chevalierid/alan-setup/fab/kicad/controller_pcb/schematic.jpeg

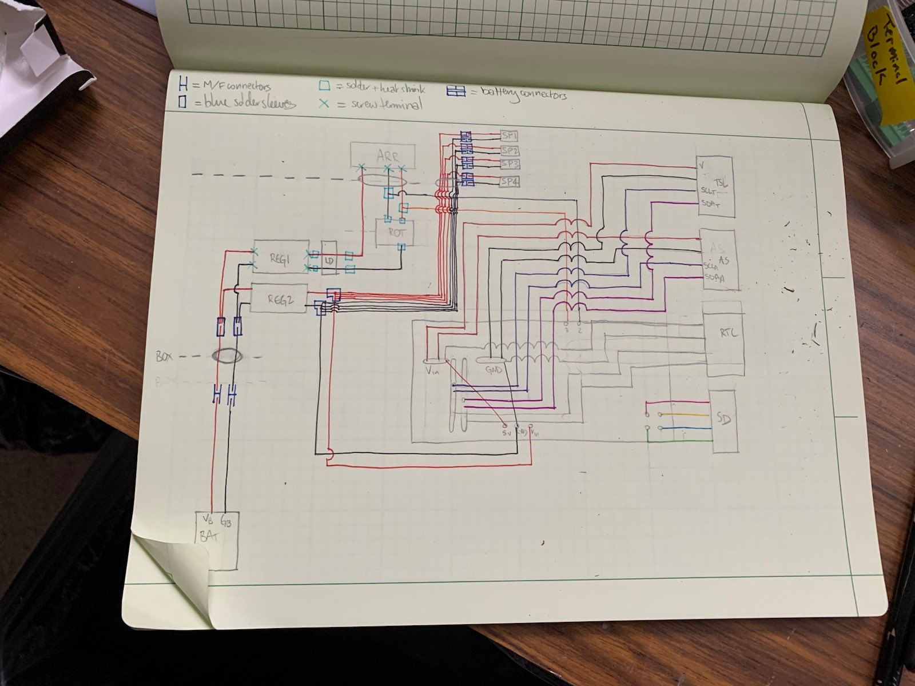
fab/kicad/controller_pcb/schematic.jpeg
