chevalierid/alan-setup/README.md

# alan-setup
Materials for experimental setup examining the effects of artificial light at night on insects
