chevalierid/alan-setup/prog/refactored/scripts/clean_sensor_data.Rmd

---
title: "clean_sensor_data"
output: html_document
date: "2024-04-24"
---

The purpose of this file is to clean the sensor data and interpolate it so that each site shares a common timescale.

```{r}
library(data.table)
library(lubridate)
library(remedy)
library(ggplot2)
```

## Read in our collated data
```{r}
sensor_data <- fread("../raw_data/raw_sensor_data_collated.csv")
metadata <- fread("../raw_data/raw_sensor_metadata_collated.csv")
```

## Remove bad/corrupted files where sensor_data LabelledSite is 0 and metadata Site is NA
```{r}
sensor_data <- sensor_data[sensor_data$LabelledSite %in% 1:12,]
```

## Sort by time
```{r}
setorder(sensor_data,cols="Timestamp")
```

### Make column for treatment (converting amber/white/on)

 A | W | O | Override | State
-------------------------
 0 | 1 | 1 | 0 | white, on
 0 | 1 | 0 | 0 | white, off
 0 | 1 | 1 | 1 | white, off, override
 1 | 1 | 1 | 0 | control, on
 1 | 1 | 0 | 0 | control, off
 1 | 1 | 1 | 1 | control, off, override
 1 | 0 | 1 | 0 | amber, on
 1 | 0 | 0 | 0 | amber, off
 1 | 0 | 1 | 1 | amber, off, override

A=0 W=1: white
A=1 W=0: amber
A=1 W=1: control

Compute treatment column as follows:
* control = A & W
* amber = A & !W
* white = !A & W

```{r}
sensor_data[, Treatment := fcase(
  sensor_data$Amber & sensor_data$White, "C",
  sensor_data$Amber & !sensor_data$White, "A",
  !sensor_data$Amber & sensor_data$White, "W"
)]
```

Any NA-treatment observations should be removed (checked).
```{r}
#sensor_data <- sensor_data[!is.na(Treatment)]
```

## Sites and states

For each labelled site and folder, we must retrieve actual site and state from metadata. 

This is harder than it first appears. We first must find the time interval corresponding to each data table entry. The metadata table contains each site's scheduled treatment for each 5-day interval and refers to each interval by its start date. In practice, the sites' states were changed on a regular schedule, but sometime during the day (slightly after the theoretical start date) rather than at midnight. We must make sure that all data corresponding to each interval is associated with that interval's start date. 

We first find points in time where treatment changed and create a new column for these timestamps (titled Changepoints).

```{r}
setorder(sensor_data,LabelledSite,Timestamp)

# here we get the row indices of every change point by site
# have to manually handle firsts, both by folder and site
sensor_data[Treatment != shift(Treatment, 1L, type="lag") | 
            Timestamp %in% sensor_data[!duplicated(sensor_data[,c("LabelledSite","Folder"),with=F])]$Timestamp, 
            Changepoint := Timestamp, by=.(LabelledSite,Folder)]
  
# have to manually handle when it's been too long since a changepoint (to capture times where there was a long gap in data collection), by folder and site

```

```{r eval = FALSE, echo = FALSE}
pdf("../plots/changepoints_before.pdf", w=16, h=9)
ggplot() +
  geom_point(data=sensor_data, aes(x=Timestamp,y=Treatment,colour=as.factor(Folder),alpha=0.5)) +
  geom_point(data=metadata, aes(x=as.POSIXct(StartDate,origin = "1970-01-01",tz="PST"),y=PrescribedTreatment,alpha=0.5)) +
  geom_point(data=sensor_data, aes(x=Changepoint,y=Treatment,colour="red")) +
  geom_vline(data = sensor_data[Intensity == -1,.SD,.SDcols = c("Timestamp","LabelledSite")], aes(xintercept = as.POSIXct(Timestamp)),alpha=0.3) +
  scale_x_datetime(
    breaks=seq(min(as.POSIXct(metadata$StartDate,origin="1970-01-01", tz="PST")),
               max(as.POSIXct(metadata$StartDate,origin="1970-01-01", tz="PST")), by="5 days"),
    date_labels = "%b %d", timezone="PST") +
  theme(axis.text.x=element_text(angle=60, hjust=1)) +
  facet_grid(rows = vars(LabelledSite))
dev.off()

pdf("../plots/changepoints2.pdf", w=16, h=9)
ggplot() +
  geom_point(data=sensor_data[LabelledSite == 11], aes(x=Timestamp,y=c("0", diff(as.numeric(Timestamp))),colour=as.factor(Folder),alpha=0.5)) +
  scale_x_datetime(
    breaks=seq(min(metadata$StartDate),max(metadata$StartDate), by="5 days"),
    date_labels = "%b %d", timezone="PST") +
  theme(axis.text.x=element_text(angle=60, hjust=1)) +
  #facet_grid(rows = vars(LabelledSite)) +
  geom_vline(data = metadata, aes(xintercept = StartDate),alpha=0.3)
dev.off()

find_data <- sensor_data[LabelledSite == 10
                         & Timestamp > as.POSIXct("2023-10-18", origin = "1970-01-01")
                         & Timestamp < as.POSIXct("2023-10-25", origin = "1970-01-01")]

find_data <- sensor_data[LabelledSite %in% c(10), Timestamp := Timestamp - hours(8)]
find_data <- find_data[LabelledSite %in% c(6), Timestamp := Timestamp - hours(7)]
find_data <- sensor_data[Timestamp > as.POSIXct("2023-10-28 09:52:11", origin = "1970-01-01", tz = "PST")
                         & Timestamp < as.POSIXct("2023-11-12 10:30:24", origin = "1970-01-01", tz = "PST")]

find_data <- sensor_data[LabelledSite == 12 & Timestamp > as.POSIXct("2023-10-28 09:52:11", origin = "1970-01-01", tz = "PST")
                                            & Timestamp < as.POSIXct("2023-11-12 10:30:24", origin = "1970-01-01", tz = "PST")]
pdf("../plots/changepoints-12.pdf", w=16, h=3)
ggplot() +
  geom_point(data=find_data, aes(x=Timestamp,y=Treatment,colour=as.factor(LabelledSite),alpha=0.5)) +
  #geom_point(data=find_data, aes(x=Changepoint,y=1,colour="red")) +
  scale_x_datetime(
    breaks=seq(min(find_data$Timestamp),max(find_data$Timestamp), by="12 hours"),
    date_labels = "%d %H", timezone="PST") +
  theme(axis.text.x=element_text(angle=60, hjust=1)) +
  facet_grid(rows = vars(Folder)) +
  geom_vline(data = find_metadata, aes(xintercept = StartDate),alpha=0.3)
dev.off()

find_data <- sensor_data[LabelledSite == 8 & Timestamp > as.POSIXct("2023-11-03 00:52:11", origin = "1970-01-01", tz = "PST")
                                            & Timestamp < as.POSIXct("2023-11-04 10:00:00", origin = "1970-01-01", tz = "PST")]
pdf("../plots/changepoints-8.pdf", w=16, h=16)
ggplot() +
  geom_point(data=find_data, aes(x=Timestamp,y=AS02,colour=as.factor(LabelledSite),alpha=0.5)) +
  geom_line(data=find_data, aes(x=Timestamp,y=Intensity,colour=as.factor(LabelledSite),alpha=0.5)) +
  #geom_point(data=find_data, aes(x=Changepoint,y=1,colour="red")) +
  scale_x_datetime(
    breaks=seq(min(as.POSIXct("2023-06-26 12:00:00", origin = "1970-01-01", tz = "PST")),
               max(as.POSIXct("2023-12-03 12:00:00", origin = "1970-01-01", tz = "PST")),
               by="24 hour"),
    date_labels = "%d %H", timezone="PST") +
  theme(axis.text.x=element_text(angle=60, hjust=1)) +
  facet_grid(rows = vars(LabelledSite)) +
  geom_vline(data = find_metadata, aes(xintercept = StartDate),alpha=0.3)
dev.off()

pdf("../plots/find_changepoints_8.pdf", w=16, h=1)
ggplot() +
  geom_point(data=find_data, aes(x=Timestamp,y=1,colour=as.factor(LabelledSite),alpha=0.5)) +
  scale_x_datetime(
    breaks=seq(min(as.POSIXct("2023-06-26 12:00:00", origin = "1970-01-01", tz = "PST")),
               max(as.POSIXct("2023-12-03 12:00:00", origin = "1970-01-01", tz = "PST")),
               by="2 hours"),
    date_labels = "%d %H", timezone="PST") +
  theme(axis.text.x=element_text(angle=60, hjust=1))
dev.off()

```

We add manual changepoints for exceptional cases. We also add a special treatment symbol because some had a wiggly cable and had a lot of NA treatment values.
```{r}
# match based on LabelledSite, Folder, and Timestamp
manual_changepoints <- fread("../raw_data/Collection Date Site Treatment and Notes(Manual).csv")
manual_changepoints[, `:=` (Timestamp = gsub("\xa0"," ",Timestamp), LastPoint = gsub("\xa0"," ",LastPoint))]
manual_changepoints[, `:=` (Timestamp = as.POSIXct(Timestamp, origin = "1970-01-01", tz="PST"),
                      LastPoint = as.POSIXct(LastPoint, origin = "1970-01-01", tz="PST"))]
manual_changepoints[, Treatment := gsub("$","*",Treatment)]
sensor_data[Changepoint %in% manual_changepoints$Timestamp]

# match row in sensor_data to row in manual_changepoints
sensor_data[manual_changepoints, `:=` (Changepoint = i.Timestamp, Treatment = i.Treatment), on = .(Folder,LabelledSite,Timestamp)]
sensor_data[Changepoint %in% manual_changepoints$Timestamp]
length(grep("*", sensor_data$Treatment, fixed=TRUE))
```

For each changepoint, we find the most recent start date in a new column, StartDate. 
```{r}
# set each value of StartDate to the closest entry in unique(metadata$StartDate)
maxless <- function(input, labels) {
  return(as.POSIXct(max(as.numeric(as.POSIXct(labels,origin="1970-01-01",tz="PST"))
                        [as.numeric(as.POSIXct(labels,origin="1970-01-01",tz="PST")) <= as.numeric(input)]),origin="1970-01-01",tz="PST"))
}
# test_data <- copy(sensor_data[1:50000])
# test_data[, StartDate := maxless(Changepoint, unique(metadata$StartDate)), by=1:nrow(test_data)]
# # input = sensor_data$Changepoint
# # labels = unique(metadata$StartDate)

#unique(metadata$StartDate)[1] < unique(metadata$StartDate)[2]
#as.POSIXct(max(as.numeric(labels)[as.numeric(labels) <= as.numeric(input)]),origin="1970-01-01")

sensor_data[, StartDate := maxless(Changepoint, unique(metadata$StartDate)), by=1:nrow(sensor_data)]
#sensor_data[, Changepoint := ifelse(as.numeric(Changepoint) - as.numeric(Timestamp))]
```

Then we fill that column downward.
```{r}
sensor_data[, StartDate := nafill(StartDate, type="locf")]
sensor_data[, StartDate := as.Date(StartDate)]
```

Then we add a Site column based on LabelledSite, Folder, and StartDate.
```{r}
sensor_data[metadata, Site := i.Site, on = .(LabelledSite,Folder,StartDate)]
```

We also need to correct the treatment column for some manual-changepoint entries.
```{r}
## select combination of folder + labelledsite + startdate where sensor_data[grep("*",Treatment)]
test_data_5 <- copy(sensor_data[Site == 5])
test_data_8 <- copy(sensor_data[Site == 8])

test_data_1 <- data.table(Site = c(5,   5,   5,   5,    5,   7,   8,    8,   8,   8,  8),        # Create first data.table
                   Treatment = c("A*", "A", "A", "W*", "W", "C", "C*", "W", "W", "W", "W"),
                   Timestamp = 1:11,
                   StartDate = c(1, 1, 1, 2, 2, 1, 1, 1, 1, 1, 1))
which(test_data_1$Treatment %like% "\\*")
test_data_1[test_data_1[which(Treatment %like% "\\*")], on=.(Site, StartDate)]
test_data_1[test_data_1[which(Treatment %like% "\\*")], NewTreatment := i.Treatment, on=.(Site, StartDate)]

length(which(test_data_5$NewTreatment %like% "\\*"))
unique(test_data_5$NewTreatment)
unique(test_data_5$Treatment)
View(test_data_5[is.na(NewTreatment)])

test_data_1[test_data_1[which(Treatment %like% "\\*")], Treatment := ifelse(!Treatment %like% "\\*", NA, Treatment), on=.(Site, StartDate)]
            
test_data_5[test_data_5[which(Treatment %like% "\\*")], Treatment := ifelse(!Treatment %like% "\\*", NA, Treatment), on=.(Site, StartDate)]

!(Treatment %like% "\\*")

[, Treatment := NA]

dt[dt[, .I[sample(.N, 1)], a]$V1, s := TRUE]

View(sensor_data[LabelledSite == 5 & Timestamp > as.POSIXct("2023-07-01 00:52:11", origin = "1970-01-01", tz = "PST")
                                   & Timestamp < as.POSIXct("2023-07-03 10:00:00", origin = "1970-01-01", tz = "PST")])
#View(2023-07-02 01:00:06)

test_data_5[test_data_5[which(Treatment %like% "\\*")], NewTreatment := i.Treatment, on=.(Site, StartDate)]

View(test_data_5[test_data_5[,.SD[which(Treatment %in% c("A*","W*","C*"))]],
            on=.(Site,StartDate)])

test_data_5[, Treatment := replace(Treatment, )]

dt[, score:= replace(score, id == 'B' & is.na(score), score[which(id == 'A')[i1]])]

View(test_data_8[test_data_8[,.SD[which(Treatment %in% c("A*","W*","C*"))]], NewTreatment := i.Treatment,
            on=.(Folder,LabelledSite,Site,StartDate)])

test_data_5[test_data_5[,.SD[which(Treatment %in% c("A*","W*","C*"))]],
            on=.(Folder,Site,LabelledSite,StartDate),
            NewTreatment := Treatment[nafill(replace(.I, is.na(Treatment), NA),"locf")]]

length(grep("*", test_data_5$Treatment, fixed=TRUE))

View(test_data_5)

View(sensor_data[LabelledSite == 8 & Timestamp > as.POSIXct("2023-11-03 00:52:11", origin = "1970-01-01", tz = "PST")
                              & Timestamp < as.POSIXct("2023-11-04 10:00:00", origin = "1970-01-01", tz = "PST")])
View(sensor_data[LabelledSite == 8 & Timestamp > as.POSIXct("2023-11-13 00:52:11", origin = "1970-01-01", tz = "PST")
                              & Timestamp < as.POSIXct("2023-11-14 10:00:00", origin = "1970-01-01", tz = "PST")])

sensor_data[sensor_data[,.SD[which(Treatment %in% c("A*","W*","C*"))]],
            on=.(Folder,LabelledSite,StartDate),
            Treatment := gsub("*","",Treatment,fixed=TRUE)]

length(grep("*", sensor_data$Treatment, fixed=TRUE))

sensor_data[LabelledSite == 5
                         & Timestamp > as.POSIXct("2023-06-26", origin = "1970-01-01")
                         & Timestamp < as.POSIXct("2023-07-26", origin = "1970-01-01")]
```

```{r}
pdf("../plots/changepoints_after.pdf", w=16, h=9)
ggplot() +
  geom_point(data=sensor_data, aes(x=Timestamp,y=Treatment,colour=as.factor(Folder),alpha=0.5)) +
  geom_point(data=metadata, aes(x=as.POSIXct(StartDate,origin="1970-01-01",tz="PST"),y=PrescribedTreatment,alpha=0.5)) +
  geom_point(data=sensor_data, aes(x=Changepoint,y=Treatment,colour="red")) +
  scale_x_datetime(
    breaks=seq(min(as.POSIXct(metadata$StartDate,origin="1970-01-01", tz="PST")),max(as.POSIXct(metadata$StartDate,origin="1970-01-01", tz="PST")), by="5 days"),
    date_labels = "%b %d", timezone="PST") +
  theme(axis.text.x=element_text(angle=60, hjust=1)) +
  facet_grid(rows = vars(Site)) +
  geom_vline(data = metadata, aes(xintercept = as.POSIXct(StartDate,origin="1970-01-01",tz="PST")),alpha=0.3)
dev.off()
```

Now we have a column stating the interval (identified by its first sampling day) for each observation. Let's properly assign site labels.
```{r}
#fread("../raw_data/Collection Date Site Treatment and Notes(LongFormat).csv")
source("reshape.R")
str(status_table)
str(metadata)
summary(status_table)

# metadata$Timestamp    & sensor_data$StartDate
# metadata$Folder       & sensor_data$Folder
# metadata$LabelledSite & sensor_data$LabelledSite
# metadata$Site         & sensor_data$Site (:=)

#metadata [, StartDate := as.Date(Timestamp),]
# Timestamp is now redundant and we only want it to refer to the timestamp of a specific observation
# PrescribedTreatment refers to the prescribed treatment, which wasn't always the treatment condition present. We will pull treatment from our observations later on

#metadata[, c("Timestamp","PrescribedTreatment") := NULL,]
sensor_data[, StartDate := as.Date(StartDate, format="%Y-%m-%d", origin = "1970-01-01",tz="PST"),]
metadata[, StartDate := as.Date(StartDate, format="%Y-%m-%d", origin = "1970-01-01",tz="PST"),]
#    long           short           long
#joined_table <- na.omit(metadata)[sensor_data, on=.(StartDate, Folder, LabelledSite)]

joined_table

joined_table <- metadata[sensor_data, on=.(StartDate, Folder, LabelledSite)][!is.na(Site)]

#joined_table[, Changepoint := NULL,]

unique(joined_table[Site == 7]$StartDate)

##################
# why don't we have data for site 7 startdate 2023-11-28...we should have it
####################

#sensor_data[Site == 7 & StartDate == as.Date("2023-11-28")]

# add actual treatment to metadata table
# some site-startdate combos have a few data points under a different treatment
# choose most common treatment for each site-startdate combo

metadata <- joined_table[Site %in% 1:12, .N, by=.(Site, StartDate, Treatment)][, .SD[which.max(N)], by = .(Site, StartDate)][metadata, on = .(Site, StartDate)]
metadata[, N := NULL,]

all.equal(metadata$Treatment[1], metadata$Folder[1])

pdf("../plots/treatments.pdf", w=16, h=9)
ggplot() +
  geom_point(data=na.omit(metadata), aes(x=as.Date(StartDate),y=Treatment,colour=as.factor(Treatment))) +
  facet_grid(rows = vars(Site))
dev.off()
```

### Get min and max timestamp
```{r}
x_min <- min(sensor_data$Timestamp)
x_max <- max(sensor_data$Timestamp)
```

## Plot before interpolation
```{r}
pdf("../plots/changepoints_final.pdf", w=16, h=9)
ggplot() +
  geom_point(data=joined_table, aes(x=Timestamp,y=Treatment,colour=as.factor(Folder),alpha=0.5)) +
  geom_point(data=metadata, aes(x=as.POSIXct(StartDate),y=PrescribedTreatment,alpha=0.5)) +
  #geom_point(data=joined_table, aes(x=Changepoint,y=Treatment,colour="red")) +
  scale_x_datetime(
    breaks=seq(min(as.POSIXct(metadata$StartDate,origin="1970-01-01", tz="PST")),
               max(as.POSIXct(metadata$StartDate,origin="1970-01-01", tz="PST")), by="5 days"),
    date_labels = "%b %d", timezone="PST") +
  theme(axis.text.x=element_text(angle=60, hjust=1)) +
  facet_grid(rows = vars(Site)) +
  geom_vline(data = metadata, aes(xintercept = as.POSIXct(StartDate)),alpha=0.3)
dev.off()
```

### Create new x
We will use linear interpolation (approxfun) from floor(min_timestamp/300) * 300 to ceiling(max_timestamp/300) * 300, using seq(from, to, by=300). Here we prepare our time-series x-variable.
```{r}
x_inter <- seq(floor(as.numeric(x_min)/300)*300,
    ceiling(as.numeric(x_max)/300)*300,
    by=300)
```

### Interpolate
```{r}
data_cols <- c(paste("AS", c(1:9), sep="0"), "AS10", "AS11", "Intensity")

interp_table <- joined_table[Site %in% 1:12, lapply(.SD, function(col) approx(x = Timestamp, y = col, xout = x_inter)$y), by=Site, .SDcols = data_cols]
interp_table[, Timestamp := as.POSIXct(x_inter,origin="1970-01-01"), by=Site]
interp_table[, Treatment := joined_table[interp_table, x.Treatment, on=.(Site, Timestamp), roll = "nearest"]]
interp_table[, StartDate := joined_table[interp_table, x.StartDate, on=.(Site, Timestamp), roll = "nearest"]]
interp_table[, LightOn := joined_table[interp_table, x.On, on=.(Site, Timestamp), roll = "nearest"]]
interp_table

pdf("../plots/interp.pdf", w=16, h=9)
ggplot(data=interp_table[Site == 6 & LightOn == 1 & Timestamp %between% c(as.POSIXct("2023-07-05"), as.POSIXct("2023-08-01"))]) +
  geom_point(aes(x=Timestamp,y=Intensity)) +
  #geom_point(aes(x=Timestamp,y=AS03),colour="blue") +
  #geom_point(aes(x=Timestamp,y=AS05),colour="green") +
  #geom_point(aes(x=Timestamp,y=AS06),colour="orange")+
  theme(text = element_text(size=rel(3.5))) +
  labs(y = "Intensity")
dev.off()

fwrite(metadata, file="../cleaned_data/metadata.csv")
fwrite(interp_table, file = "../cleaned_data/interpolated_data.csv")
```
