chevalierid/alan-setup/prog/processing.Rmd

```{r}
library(data.table)
library(ggplot2)
library(lubridate)
library(remedy)
```
## Set working directory
```{r setup}
knitr::opts_knit$set(root.dir="~/Documents/alan-setup")
```

### Import labels table (prescribed states)
```{r}
source("./prog/site_assign_label_gen.R")
labels_table <- melt(setDT(labels), measure = patterns(c("^dates_out","^sites","^site_settings")),
     value.name = c("Timestamp", "LabelledSite", "LTreatment"))
labels_table <- labels_table[,.SD,
             .SDcols = c("Timestamp", "LabelledSite", "LTreatment")]
labels_table$Timestamp <- with_tz(as.POSIXct(labels_table$Timestamp), "PST")
setorder(labels_table,Timestamp)
```

### Import status table (whether sites were collecting data over a given interval)
```{r}
source("./prog/reshape.R")
str(status_table)
str(labels_table)
summary(status_table)
#max(labels_table[Timestamp <= max(status_table$Date)]$Timestamp)
# equality comparison works between labels_table$Timestamp and status_table$Date :-)

# trim labels_table
labels_table <- labels_table[Timestamp <= max(status_table$Timestamp)]
#labels_table <- labels_table[Timestamp %in% status_table$Timestamp]

#labels_table <- labels_table[status_table, on = c("Timestamp" , "LabelledSite")]

# add a column to labels_table that indicates the actual status of given site at given interval
# retrieve status_table$Status by matching labels_table$Timestamp to status_table$Timestamp and labels_table$Site to status_table$Site

# view(labels_table[status_table, on = c("Timestamp","LabelledSite"), fcase(
#   !(i.Status %in% c("", "dep")) | is.na(i.Folder) | is.na(i.Site), 0,
#   default = 1
#   )])

labels_table[status_table, on = c("Timestamp","LabelledSite"), c("Status","Folder","Site") := list(fcase(
  !(i.Status %in% c("", "dep")) | is.na(i.Folder) | is.na(i.Site), 0,
  default = 1
  ), i.Folder, i.Site)]

head(labels_table)
```

### Downloading sensor data
* s3cmd la
* s3cmd get --recursive s3://alan-stations-sensordata/
* stored in alan-setup/sensordata

### Set up timeframe bounds
We want to bound the time frame within study period (hardcoded in here) to only download files that are from the correct timespan. Recall the format string is month.day.hour.
```{r}
start_date <- as.POSIXct("23.06.21.00",format="%y.%m.%d.%H")
end_date <- as.POSIXct("23.12.04.23",format="%y.%m.%d.%H")
all_dates <- seq.POSIXt(start_date, end_date, "hour")

all_dates <- format(all_dates,"%m-%d-%H")
```

### Format file names as dates
We need to remove the ".CSV" termination and convert the remaining string to a POSIXct (date-time) format. Malfunctioning clocks resulted in some data saved under impossible dates, e.g. 85-9-18, so we want to remove those as well.
```{r}
reform <- function (site_files_arg) {
  site_files_arg <- gsub(".CSV|\"","",site_files_arg)
  site_files_arg <- gsub("^","23-",site_files_arg)
  site_files_arg <- as.POSIXct(site_files_arg,format="%y-%m-%d-%H")
  format(site_files_arg,"%m-%d-%H")
}
```

### Get all site paths
```{r}
sites <- list.files(path="./sensordata", full.names = TRUE)
header <- c("Timestamp", "LabelledSite", "Amber", "White", "On", "Override", "Intensity",
               "AS00", "AS01", "AS02", "AS03", "AS04", "AS05", "AS06", "AS07", "AS08",
               "AS09", "AS10", "AS11")
```
 
### Reading in files
For a given site path, we want to read in and rbind together all non-blank files whose names fall within our timeframe. Some files have headers while others don't, so we always set the file header manually.
```{r}
get_files <- function(site) {
  files_within_bounds <- list.files(site)[reform(list.files(site)) %in% all_dates]
  # exclude blank files
  files_within_bounds <- files_within_bounds[file.size(paste(site,"/",files_within_bounds,sep=""))>0]
  site_table <- do.call(rbind,lapply(files_within_bounds,function(file) {
    data <- read.csv(paste(site,"/",file,sep=""))
    names(data) <- header
    return(data)
    # 2
  }))
}
```

### Read in data from all sites
```{r}
raw_output <- lapply(sites,get_files)
```

List of dataframes
```{r}
big_table <- raw_output
```

Now we have a list of dataframes. Some have char columns only, other have int and num. We'll have to convert them all before combining into a master table.

### Convert timestamp column to POSIXct
This has the added bonus of removing rogue "header rows" since their timestamp (which just reads "Timestamp") is converted to NA and excluded from the subset.
```{r}
big_table <- lapply(big_table, function(df) {
  df$Timestamp <- with_tz(as.POSIXct(as.numeric(df$Timestamp), origin = "1970-01-01"), "PST")
  df <- subset(df, Timestamp > start_date & Timestamp < end_date)
})
```

### Convert all the other columns to the correct type
```{r}
big_table <- lapply(big_table, function(df) {
  df[,-1] <- lapply(df[,-1], type.convert, as.is = TRUE)
  return(df)
    })
```

### Merge into a single data.table
Take unique values since some files were duplicated
```{r}
big_table <- unique(rbindlist(big_table,idcol="Folder"))
```

### Count how many of each timestamp for each LabelledSite and Folder
```{r}
big_table[,.N,by=.(as.Date(Timestamp),LabelledSite,Folder)][N>288]
```

### Remove bad/corrupted files where LabelledSite is 0
### Sort by time
```{r}
big_table <- big_table[big_table$LabelledSite %in% 1:12,]
str(labels_table)
# fix labels_table, up above
# match:
  # labels_table$Timestamp to big_table$Timestamp
  # labels_table$

#labels_table[Timestamp==big_table$Timestamp,]

# labels_table[status_table, on = c("Timestamp","LabelledSite"), c("Status", "Folder", "Site") := list(fcase(
#   i.Status %in% c("", "dep") | is.na(i.Folder) | is.na(i.Site), 1,
#   default = 0 # FIXME add a case for NA folder and site
#   ), i.Folder, i.Site)]

setorder(big_table,cols = "Timestamp")
```

### Make column for treatment (converting amber/white/on)

 A | W | O | Override | State
-------------------------
 0 | 1 | 1 | 0 | white, on
 0 | 1 | 0 | 0 | white, off
 0 | 1 | 1 | 1 | white, off, override
 1 | 1 | 1 | 0 | control, on
 1 | 1 | 0 | 0 | control, off
 1 | 1 | 1 | 1 | control, off, override
 1 | 0 | 1 | 0 | amber, on
 1 | 0 | 0 | 0 | amber, off
 1 | 0 | 1 | 1 | amber, off, override

A=0 W=1: white
A=1 W=0: amber
A=1 W=1: control

Compute treatment column as follows:
* control = A & W
* amber = A & !W
* white = !A & W

```{r}
big_table[, Treatment := fcase(
  big_table$Amber & big_table$White, "C",
  big_table$Amber & !big_table$White, "A",
  !big_table$Amber & big_table$White, "W"
  #,!big_table$Amber & !big_table$White, "U"
)]
```

Any NA-treatment observations should be removed (checked).
```{r}
big_table[is.na(Treatment), .N]
dim(big_table[is.na(Treatment)])
dim(big_table[!is.na(Treatment)])
big_table <- big_table[!is.na(Treatment)]
```

### For each labelled site and folder, retrieve actual site and state from labels_table
This is harder than it first appears. We first must find the time interval corresponding to each data table entry. The labels table contains each site's scheduled treatment for each 5-day interval and refers to each interval by its start date. In practice, the sites' states were changed on a regular schedule, but sometime during the day (slightly after the theoretical start date) rather than at midnight. We must make sure that all data corresponding to each interval is associated with that interval's start date. We first find points in time where treatment changed and create a new column for these timestamps (titled Changepoints).

```{r}
## get the timestamps at which treatment changes
# must group by LabelledSite and order by timestamps
# then find changepoints

setorder(big_table,LabelledSite,Timestamp)

# here we get the row indices of every change point by site
# have to manually handle firsts, both by folder and site

big_table[Treatment != shift(Treatment, 1L, type="lag") | Timestamp %in% big_table[!duplicated(big_table[,c("LabelledSite","Folder"),with=F])]$Timestamp, Changepoint := Timestamp, by=.(LabelledSite,Folder)]

```

For each changepoint, we find the most recent start date in a new column, StartDate. Then we fill that column downward with NAs.
```{r}
# set each value of StartDate to the closest entry in unique(labels_table$Timestamp)
maxless <- function(input, labels) {
  return(as.POSIXct(max(as.numeric(labels)[as.numeric(labels) <= as.numeric(input)]),origin="1970-01-01"))
}

#view(big_table[, maxless(Changepoint, labels_table$Timestamp), by=1:nrow(big_table)])
big_table[, StartDate := maxless(Changepoint, unique(labels_table$Timestamp)), by=1:nrow(big_table)]

big_table[, StartDate := nafill(StartDate, type="locf")]
```

Now we have a column stating the interval (identified by its first sampling day) for each observation. Let's properly assign site labels.
```{r}
# labels_table$Timestamp    & big_table$StartDate
# labels_table$Folder       & big_table$Folder
# labels_table$LabelledSite & big_table$LabelledSite
# labels_table$Site         & big_table$Site (:=)

# labels_table[status_table, on = c("Timestamp","LabelledSite"), 
#              c("Status", "Folder", "Site") := list(fcase(
#   i.Status %in% c("", "dep") | is.na(i.Folder) | is.na(i.Site), 1,
#   default = 0
# ), i.Folder, i.Site)]

# dt_a[dt_b, on = .(b = y, c > z)]

# labels_table[status_table, on = c("Timestamp","LabelledSite"), c("Status","Folder","Site") := list(fcase(
#   !(i.Status %in% c("", "dep")) | is.na(i.Folder) | is.na(i.Site), 0,
#   default = 1
#   ), i.Folder, i.Site)]

# view(big_table[labels_table, on=.(StartDate = Timestamp, Folder = Folder, LabelledSite = LabelledSite),
#           i.Site])
labels_table [, StartDate := as.Date(Timestamp),]
labels_table[, c("Timestamp","LTreatment") := NULL,]
big_table[, StartDate := as.Date(StartDate),]

#joined_table <- na.omit(labels_table[, !c("Timestamp","LTreatment", with = FALSE)])[big_table, on=.(StartDate, Folder, LabelledSite)]
joined_table <- na.omit(labels_table)[big_table, on=.(StartDate, Folder, LabelledSite)]

joined_table[, Changepoint := NULL,]

```

```{r}
#unclass(changepoints[LabelledSite==10 & Timestamp < as.POSIXct("2023-08-01") & Timestamp > as.POSIXct("2023-07-30")]$Timestamp)
# on Jul 31, site 10 was changed at 11:48ish
# RTC says 2023-07-31 18:53:44
# this implies that 7h should be subtracted from all the timestamps
# makes sense! UTC = PST + 7
# if we unclass we get 1690829624 which, according to EpochConverter, is 18:53:44 UTC and 11:53:44 PST
# our timestamps are correct, but they display in UTC
```

```{r}
# pdf("changepoints.pdf", w=16, h=9)
# ggplot() +
#   #geom_point(data=big_table, aes(x=Timestamp,y=Treatment,colour=as.factor(Folder))) +
#   geom_point(data=labels_table, aes(x=Timestamp,y=LTreatment,alpha=0.5)) +
#   geom_point(data=changepoints, aes(x=Timestamp,y=Treatment,colour="yellow")) +
#   scale_x_datetime(
#     breaks=seq(min(labels_table$Timestamp),max(labels_table$Timestamp), by="5 days"),
#     date_labels = "%b %d", timezone="PST") +
#   theme(axis.text.x=element_text(angle=60, hjust=1)) +
#   facet_grid(rows = vars(LabelledSite)) +
#   geom_vline(data = labels_table, aes(xintercept = Timestamp),alpha=0.3)
# dev.off()
```

```{r}
pdf("startdates.pdf", w=16, h=9)
ggplot() +
  # plot changepoint against startdate
  geom_point(data=big_table, aes(x=as.Date(Changepoint),y=Treatment,colour=as.factor(StartDate))) +
  geom_point(data=big_table, aes(x=StartDate,y=Treatment,colour=as.factor(StartDate))) +
  # scale_x_date(
  #   date_breaks=seq(min(big_table$StartDate),max(big_table$StartDate), by="5 days"),
  #   date_labels = "%b %d") +
  theme(axis.text.x=element_text(angle=60, hjust=1)) +
  facet_grid(rows = vars(LabelledSite))
  # geom_vline(data = labels_table, aes(xintercept = Timestamp),alpha=0.3)
dev.off()
```

```{r}
pdf("changepoints.pdf", w=16, h=9)
ggplot() +
  geom_point(data=big_table, aes(x=Timestamp,y=Treatment,colour=as.factor(Folder))) +
  geom_point(data=labels_table, aes(x=Timestamp,y=LTreatment,alpha=0.5)) +
  geom_point(data=changepoints, aes(x=Timestamp,y=Treatment,colour="red",alpha=0.5)) +
  scale_x_datetime(
    breaks=seq(min(labels_table$Timestamp),max(labels_table$Timestamp), by="5 days"),
    date_labels = "%b %d", timezone="PST") +
  theme(axis.text.x=element_text(angle=60, hjust=1)) +
  facet_grid(rows = vars(LabelledSite)) +
  geom_vline(data = labels_table, aes(xintercept = Timestamp),alpha=0.3)
dev.off()
```

### Get min and max timestamp
```{r}
x_min <- min(big_table$Timestamp)
x_max <- max(big_table$Timestamp)
```

### Create new x
Use linear interpolation (approxfun) from floor(min_timestamp/300) * 300 to ceiling(max_timestamp/300) * 300, using seq(from, to, by=300). Do all of this for one series.

```{r}
x_inter <- seq(floor(as.numeric(x_min)/300)*300,
    ceiling(as.numeric(x_max)/300)*300,
    by=300)
```

How many observations actually have override triggered?
```{r}
big_table[Override==1]
```
Just 5...

Look at min difference between observations in a given interval to determine whether multiple sets accidentally collected under same labels.
```{r}
# #big_table[, lapply(.SD, get_min_diff), by=Site, .SDcols = "Timestamp"]
# #id_table <- unique(rbindlist(big_table,idcol="Folder"))
# 
# get_min_diff <- function(data) {
#   return(min(abs(diff(as.numeric(data,origin="1970-01-01"))),na.rm=TRUE))
# }
# 
# min_diffs <- big_table[, lapply(.SD, get_min_diff), by=.(Site,Folder), .SDcols = "Timestamp"]
# min_diffs
# 
# dcast(min_diffs, Site ~ Folder, value.var = "Timestamp")
```

## Compare with official states

How many C, A, W states at each site? How many state changes?
```{r}
big_table[, .N, by=.(Site, Treatment)][order(Site,Treatment)]
#changepoints <- changepoints[,.SD, .SDcols = names(labels_table)]
```

Pulling expected state from labels table:
```{r}
#labels_table[ big_table, x.LTreatment, on = .(Site, Timestamp), roll = Inf ]
#big_table[, LTreatment := labels_table[ big_table, x.LTreatment, on = .(Site, Timestamp), roll = Inf ] ]
#dim(big_table[Treatment==LTreatment])
#dim(big_table[Treatment != LTreatment])
```

### Visualise the intended and actual state changes over time for each site
We want to catch cases where files were saved with the wrong Site. 
--> don't match up with their plotted Site's ons and offs
--> coloured with a different folder
--> in interval table, manually indicate which folder each in
| site | labelled site | folder

```{r}
# ggplot() +
#   geom_point(data=big_table, aes(x=Timestamp,y=Treatment),colour="orange") +
#   geom_point(data=labels_table, aes(x=Timestamp,y=LTreatment,colour=as.factor(Status))) +
#   facet_grid(rows = vars(Site))

pdf("overlap.pdf", w=16, h=9)
ggplot() +
  geom_point(data=big_table, aes(x=Timestamp,y=Treatment,colour=as.factor(Folder))) +
  geom_point(data=labels_table, aes(x=Timestamp,y=LTreatment,alpha=as.factor(Status))) +
  scale_x_datetime(
    breaks=seq(min(labels_table$Timestamp),max(labels_table$Timestamp), by="5 days"),
    date_labels = "%b %d", timezone="PST") +
  theme(axis.text.x=element_text(angle=60, hjust=1)) +
  facet_grid(rows = vars(Site)) +
  geom_vline(data = labels_table, aes(xintercept = Timestamp),alpha=0.3)
dev.off()
```

Repeated from above but slightly different (FIXME). Checking minimum time difference between observations for a given site (e.g. determine whether a given dataset has been mislabelled as a different dataset):
```{r}
get_min_diff <- function(data) {
  return(min(abs(diff(as.numeric(data,origin="1970-01-01")))))
}
big_table[, lapply(.SD, get_min_diff), by=Site, .SDcols = "Timestamp"]
```

### learn more about unsorted time series
```{r}
diag_table <- data.table(
  site = big_table[, by=Site, is.unsorted(Timestamp)]$LabelledSite,
  is_unsorted = big_table[, by=Site, is.unsorted(Timestamp)]$V1,
  min_diff = big_table[, by=Site, as.difftime(min(diff(as.numeric(Timestamp),origin="1970-01-01"))/60/60/24,units="days")]$V1,
  min = big_table[, by=Site, min(Timestamp)]$V1,
  max = big_table[, by=Site, max(Timestamp)]$V1,
  max_minus_min = big_table[, by=Site, max(Timestamp)-min(Timestamp)]$V1
)
setorder(diag_table,cols="site")
diag_table
```

### Interpolate

```{r}
# change to:
# subdata_x = joined_table$Timestamp
# subdata_y = columns in range of columns (since we will be using lapply here)
# approx_x <- function(subdata_y, subdata_x, x_inter_arg) {
#   # subdata_y = multiple columns of data????
#   return(na.omit(as.data.table(approx(x = subdata_x, y = subdata_y, xout = x_inter_arg, method = "linear")))$y)
# }

data_cols <- c(paste("AS", c(1:9), sep="0"), "AS10", "AS11", "Intensity")

interp_table <- joined_table[Site %in% 1:12, lapply(.SD, function(col) approx(x = Timestamp, y = col, xout = x_inter)$y), by=Site, .SDcols = data_cols]
interp_table[, Timestamp := as.POSIXct(x_inter,origin="1970-01-01"), by=Site]
interp_table[, Treatment := joined_table[interp_table, x.Treatment, on=.(Site, Timestamp), roll = "nearest"]]
interp_table[, StartDate := joined_table[interp_table, x.StartDate, on=.(Site, Timestamp), roll = "nearest"]]
interp_table[, LightOn := joined_table[interp_table, x.On, on=.(Site, Timestamp), roll = "nearest"]]
interp_table

pdf("interp.pdf", w=16, h=9)
ggplot(data=interp_table[Site == 6 & LightOn == 1 & Timestamp %between% c(as.POSIXct("2023-07-01"), as.POSIXct("2023-08-01"))]) +
  geom_point(aes(x=Timestamp,y=Intensity,colour=as.factor(Treatment))) +
  geom_point(aes(x=Timestamp,y=AS03),colour="blue") +
  geom_point(aes(x=Timestamp,y=AS06),colour="orange")
dev.off()

pdf("interp.pdf", w=16, h=9)
ggplot(data=interp_table[Site == 6 & LightOn == 1 & Timestamp %between% c(as.POSIXct("2023-07-01"), as.POSIXct("2023-08-01"))]) +
  geom_point(aes(x=Timestamp,y=Intensity),colour="black") +
  scale_y_log10()
dev.off()

#                         from labels_table
#labels_table[ big_table, x.LTreatment, on = .(Site, Timestamp), roll = Inf ]
#big_table[, LTreatment := labels_table[ big_table, x.LTreatment, on = .(Site, Timestamp), roll = Inf ] ]
#dim(big_table[Treatment==LTreatment])
#dim(big_table[Treatment != LTreatment])

fwrite(labels_table)
fwrite(interp_table, file = "prog/interpolated_data.csv")
getwd()
```

```{r}
# approx_table <- big_table[,approx_x(.SD,x_inter)
#            ,by=Site]

approx_table <- big_table[,approx_x(.SD,x_inter)
                          ,by=c("Site","Treatment")]
pdf("site2_plot.pdf", w=16, h=9)
# ggplot(approx_table[Site==2], aes(x=x,y=y)) +
#  geom_point(alpha=0.3)#+
#  facet_grid(rows = vars(Site))

# FIXME check interpolation

ggplot(approx_table[Site==2], aes(x=x,y=c(NA,diff(x)))) +
  geom_point(alpha=0.3)

dev.off()

```
* we should refer to a site's interval by its start date
* to derive from a given POSIXct: as.numeric(floor(this_date - start_date)/5) + 1
* however this might be challenging: midnight isn't when we were changing the traps
* maybe instead find nearest changepoint <= current_timestamp, then nearest value in labels$Timestamp <= changepoint

# make long table with intensity as a channel

# can take SD as argument
# 

# make this work by converting treatment column

ggplot(approx_table, aes(x=as.POSIXct(x, origin = "1970-01-01"),y=y)) +
  geom_line() +
  facet_wrap(~Site) +
  scale_x_datetime()

# another column
# approx_table[channels="Intensity"]
# grid: 

ggplot(approx_table, aes(x=as.POSIXct(x, origin = "1970-01-01"),y=y)) +
  geom_line() +
  facet_wrap(~Site) +
  scale_x_datetime(name="Date")

str(approx(x = site_tables_list[[1]]$Timestamp, y = site_tables_list[[1]]$Intensity,
              xout = x_inter, method = "linear"))

interp_1 <- approx(x = site_tables_list[[1]]$Timestamp, y = site_tables_list[[1]]$Intensity,
       xout = x_inter, method = "linear")
interp_1 <- as.data.frame(interp_1)

plot(na.omit(interp_1))

# median filter (runmed)

# bmtest table:
# 10 biomass measurements
# 10 dates
BmDate = seq.Date(from = as.Date("2023/06/01"), by = "5 days", length.out = 10)
set.seed(1)
bmtest <- data.table(
  BmDate,
  Biomass = rnorm(10, mean = 2, sd = 1)
)
bmtest

# stest table:
# 7 sensor measurements
# 7 dates
stest <- data.table(
  SDate = sort(sample(BmDate,7)),
  Sensor = rnorm(7, mean = 1000, sd = 300)
)
stest

setkey(stest,"SDate")
setkey(bmtest,"BmDate")
bmtest[stest, roll = TRUE]

# now to apply rolling joins to our actual data
# - table of biomass data
# - table of sensor measurements over time
# - want to associate each biomass datapoint with a sensor measurement

# 1
{
  #all.equal(header,unlist(names_1[1])
  #all_files <- lapply(sites,list.files)
  
  ## get a list of file names for given site
  #site_files <- list.files(sites[4])
  # length(reform(site_files))
  # length(all_dates)
  # length(reform(site_files)[reform(site_files) %in% all_dates])
  #files_within_bounds <- site_files[reform(site_files) %in% all_dates]
}

# 2
{    #print(names(data))
  #   #print(file)
  #   #try(print(names(read.csv(paste(site,"/",file,sep="")))))
  #   tryCatch(
  #     {
  #       all.equal(names(read.csv(paste(site,"/",file,sep=""))),header)
  #       read.csv(paste(site,"/",file,sep=""))
  #     },
  #     error=function(e) {
  #       read.csv(paste(site,"/",file,sep=""),header = FALSE)
  #     }
  #   )
  #   #names(data) <- header
}

# 3
{# #
  # si <- 3
  # files_within_bounds <- list.files(sites[si])[reform(list.files(sites[si])) %in% all_dates]
  # files_within_bounds <- files_within_bounds[file.size(paste(sites[si],"/",files_within_bounds,sep=""))>0]
  # site_table_1 <- lapply(files_within_bounds,function(file) {
  #   tryCatch(
  #     {
  #       read.csv(paste(sites[si],"/",file,sep=""))
  #     },
  #     error=function(e) {
  #       read.csv(paste(sites[si],"/",file,sep=""), header = FALSE)
  #     }
  #   )
  # })
  # 
  # names_1 <- lapply(site_table_1,names)
  # for (i in 1:length(names_1)) {
  #   #try (all.equal(names_1[i],names_1[1]))
  #   print(paste(i, files_within_bounds[i], names_1[i]))
  #   if (!all.equal(names_1[i],names_1[1])) {
  #     print(files_within_bounds[i])
  #   }
  # }
  # 
  # all.equal(tail(names_1,n=1),names_1[1])
  # 
  # 
  # all(sapply(names_1, identical, names_1[1]))
  # names_1[1]
  # 
  # files_within_bounds <- list.files(sites[3])[reform(list.files(sites[3])) %in% all_dates]
  # files_within_bounds <- files_within_bounds[file.size(paste(sites[3],"/",files_within_bounds,sep=""))>0]
  # site_table_3 <- lapply(files_within_bounds,function(file) {
  #   read.csv(paste(sites[3],"/",file,sep=""))
  # })
  # 
  # str(get_files(sites[1]))
  # str(get_files(sites[3]))
  # for (i in 1:length(files_within_bounds)) {
  #   print(files_within_bounds[i])
  #   rbind_debug <- rbind(rbind_debug, read.csv(paste(sites[3],"/",files_within_bounds[i],sep="")))
  # }
  # 
  # site_table <- do.call(rbind,lapply(files_within_bounds,function(file) {
  #   read.csv(paste(site,"/",file,sep=""))
  # }))
  #
}

# 4
{
  # # convert one single dataframe's columns
  # lapply(
  #   big_table[[1]],type.convert,as.is = TRUE)
  # # double-check this worked
  # lapply(
  #   lapply(
  #     big_table[[1]],type.convert,as.is = TRUE),class)
  
}

# 5
{
  # # double-check this worked
  # #lapply(
  # str(
  # lapply(
  #   big_table, function(df) {
  #     lapply(df,type.convert, as.is = TRUE)
  #   })
  # )
  # #  [1],class)
}

# 6
{
  # for every timestamp in big_table, we want to retrieve the corresponding treatment value from the labels table (what it's SUPPOSED to be)
  # e.g. big_table$Timestamp "2023-06-29 09:26:07 PST"
  # find 2023-06-26
  # NOT 2023-07-01
  # rolling join closest(x >= y) where x = big_table$Timestamp and y = labels_table$Timestamp
  
  # print(df1)
  # ticker       date
  # 1   AAPL 2019-01-06
  # 2   AAPL 2019-02-06
  # 3   MSFT 2019-01-06
  # 4   MSFT 2019-05-02
  # 
  # 
  # print(df2)
  # ticker       date  randomVar
  # 1   AAPL 2019-01-03 -0.5321493
  # 2   AAPL 2019-01-07 -0.7909461
  # 3   AAPL 2019-02-06  0.2121993
  # 4   MSFT 2019-01-05  1.2336315
  # 5   MSFT 2019-01-07 -0.2729354
  # 6   MSFT 2019-05-02 -0.5349596
  # 
  # 
  # #convert sample data to data.table
  # setDT(df1)
  # setDT(df2)
  
  # #update df1 by reference with a rolling join
  # df1[, randomVar := df2[ df1, x.randomVar, on = .(ticker, date), roll = Inf ] ]
  # 
  # 
  # #    ticker       date  randomVar
  # # 1:   AAPL 2019-01-06 -0.5321493
  # # 2:   AAPL 2019-02-06  0.2121993
  # # 3:   MSFT 2019-01-06  1.2336315
  # # 4:   MSFT 2019-05-02 -0.5349596
  # 
  # 
  # 
  # # in their case:
  # # get ticker from df1 (site number)
  # # get date from df1 (timestamp)
  # # get nearest randomVar from df2 (treatment)
  # 
  # # in our case:
  # # get Site from big_table
  # # get Timestamp from big_table
  # # get nearest Treatment from labels_table
  
}
