chevalierid/alan-setup/prog/refactored/plots/count_all_points.pdf

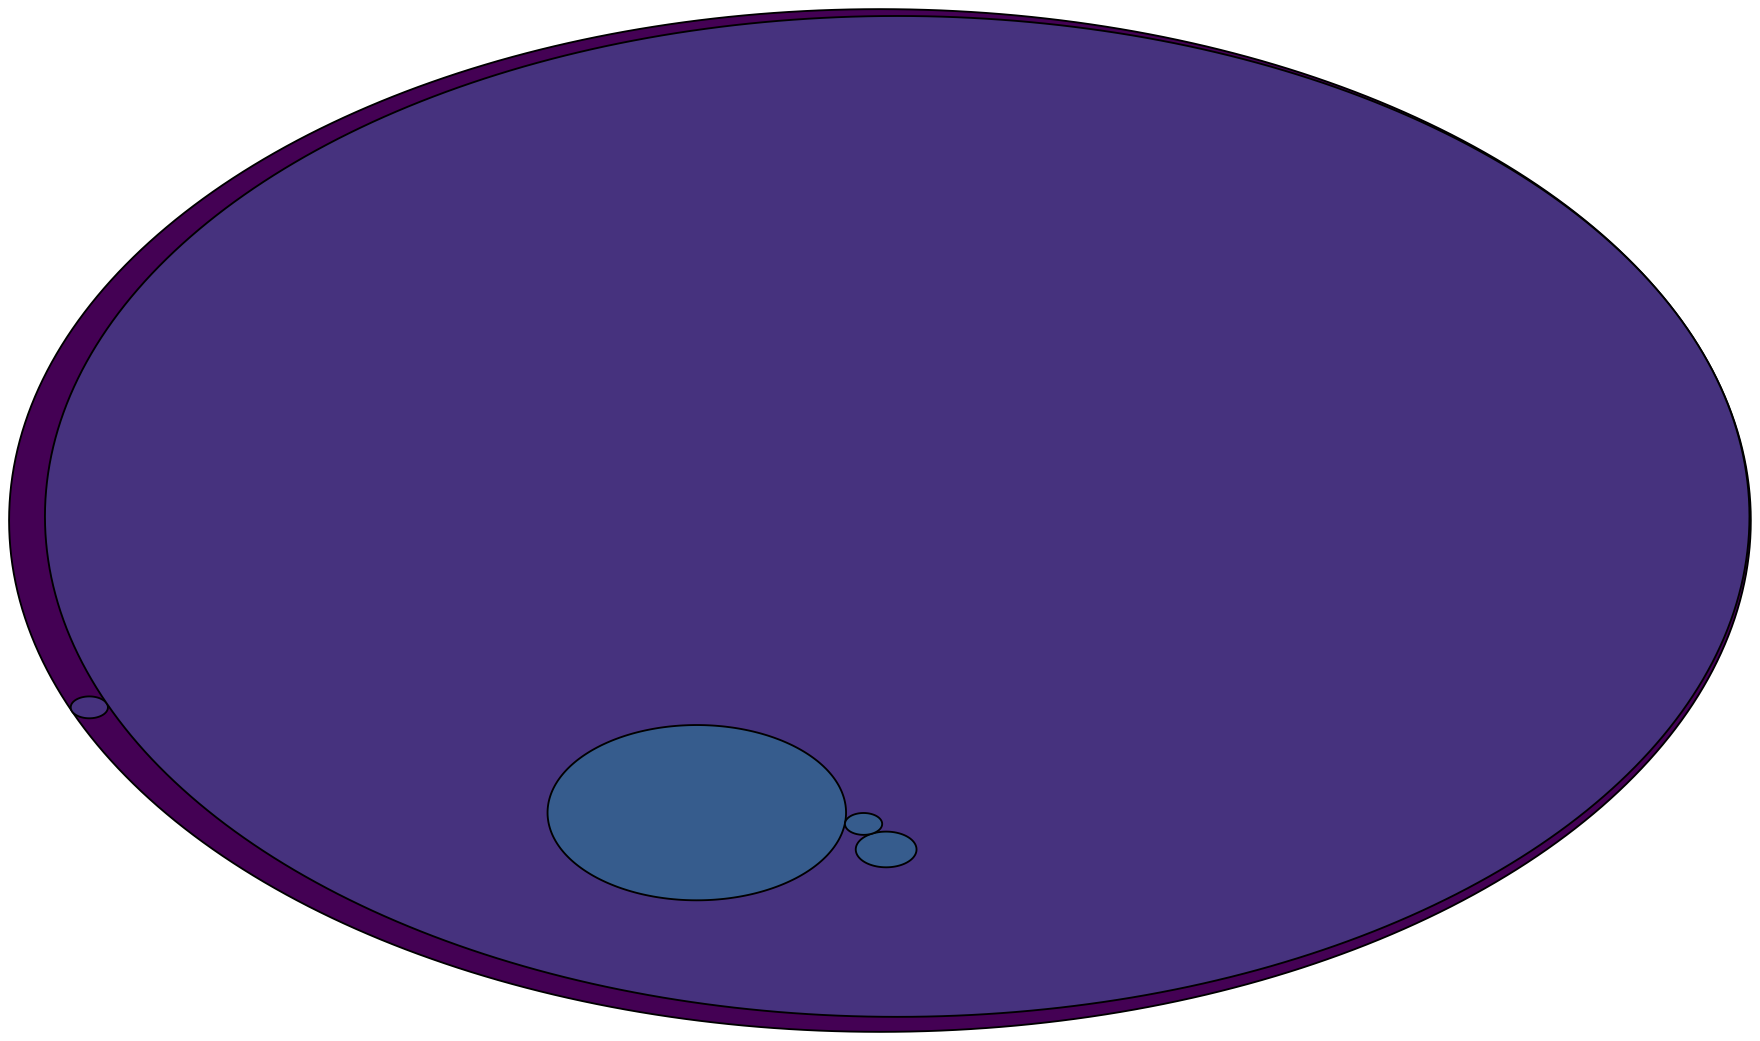
[picture p2: page 1]

# unclassified_arthropod

### Chilopoda

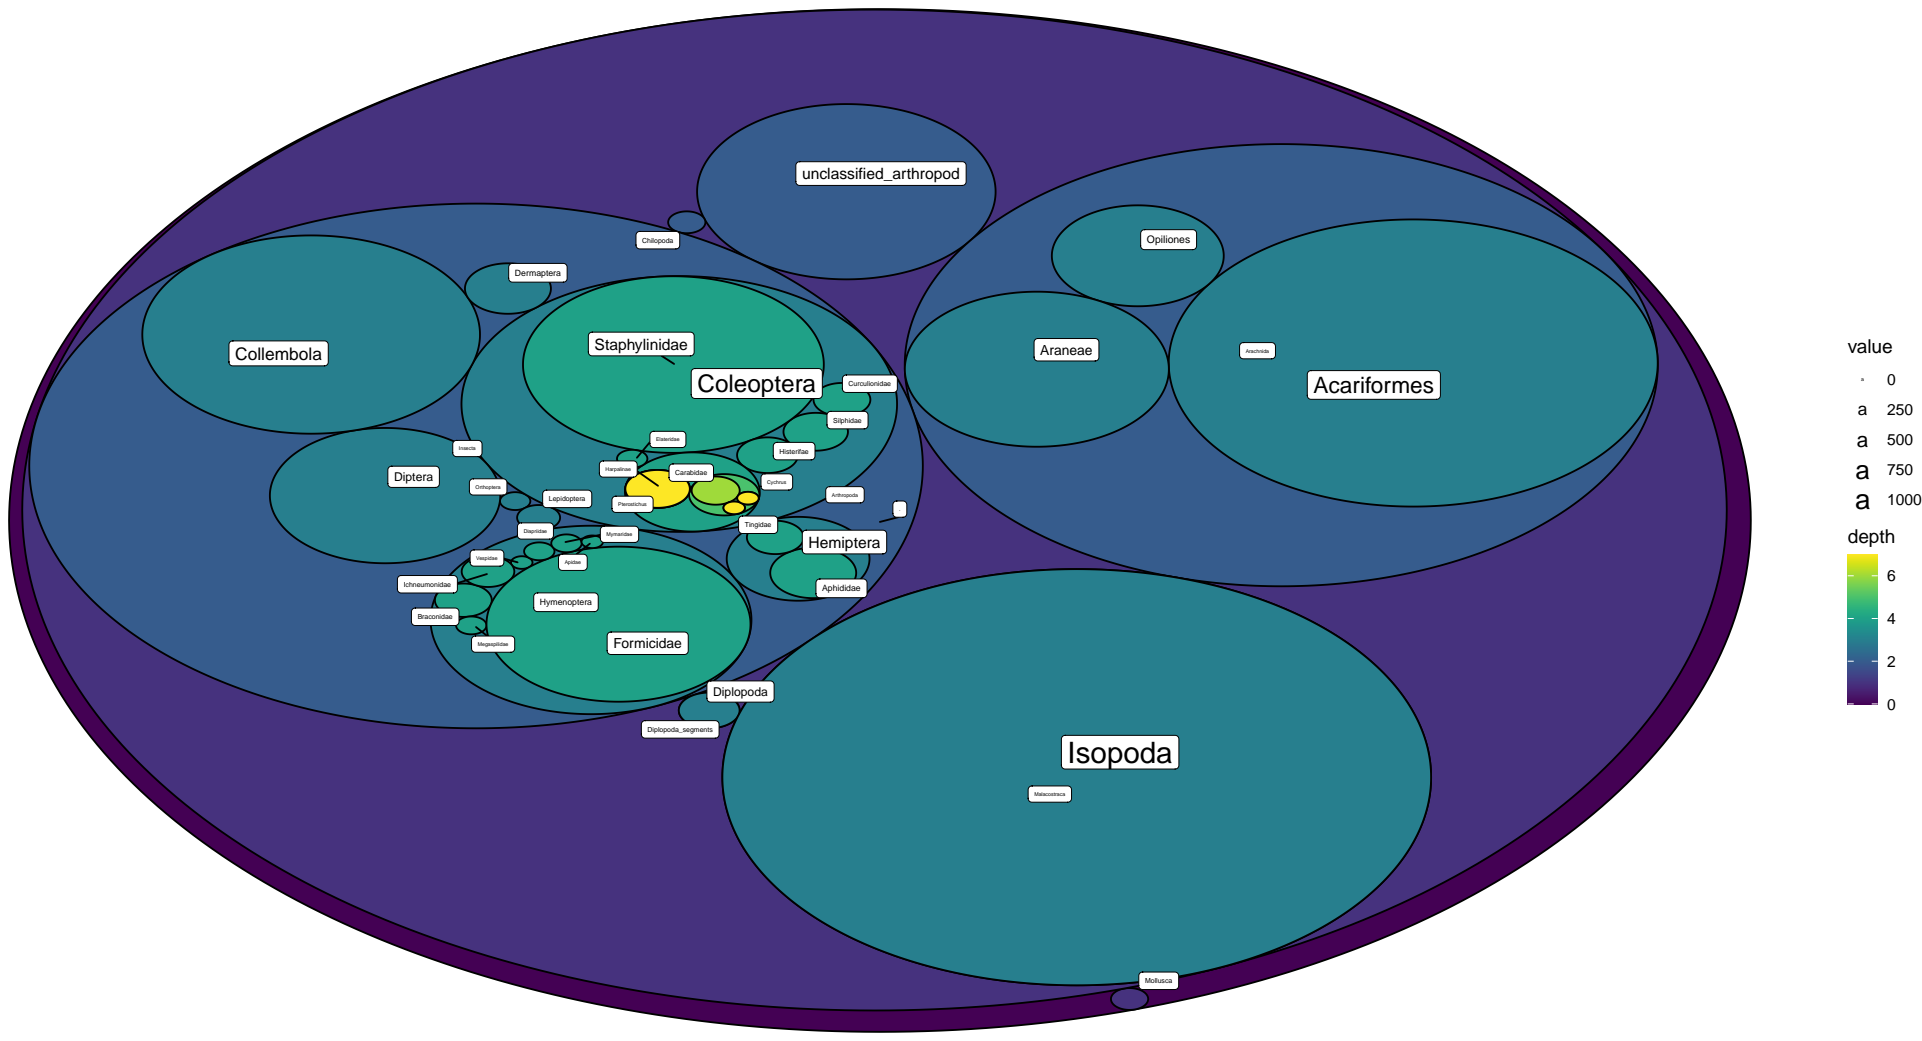
[picture p3: page 5]
Mollusca; Arthropoda; Diplopoda; Arachnida; Malacostraca; Insecta; Diplopoda_segments; Acariformes; Opiliones; Araneae; Isopoda; Orthoptera; Hymenoptera; Hemiptera; Lepidoptera; Coleoptera; Diptera; Collembola; Dermaptera; Vespidae; Braconidae; Megaspilidae; Ichneumonidae; Formicidae; Diapriidae; Mymaridae; Apidae; Aphididae; Tingidae; Curculionidae; Silphidae; Staphylinidae; Histerifae; Carabidae; Elateridae; Harpalinae; Cychrus; Pterostichus; value; depth
