chevalierid/alan-setup/(threads)

Thread 1 (2022-10-28):

Light switching on schedule

chevalierid, 2022-10-28:
- [x] Sensor dummy file
- [x] Hardcode schedule
- [x] Switch function

chevalierid, 2022-11-08:
- [ ] Fix posix time bug
- [ ] Full datestamp in filename (not just hour or minute number)

Closed 2023-01-16.
