chevalierid/alan-setup/prog/refactored/plots/hierarch_test.pdf

# Hymenoptera

### Lepidoptera

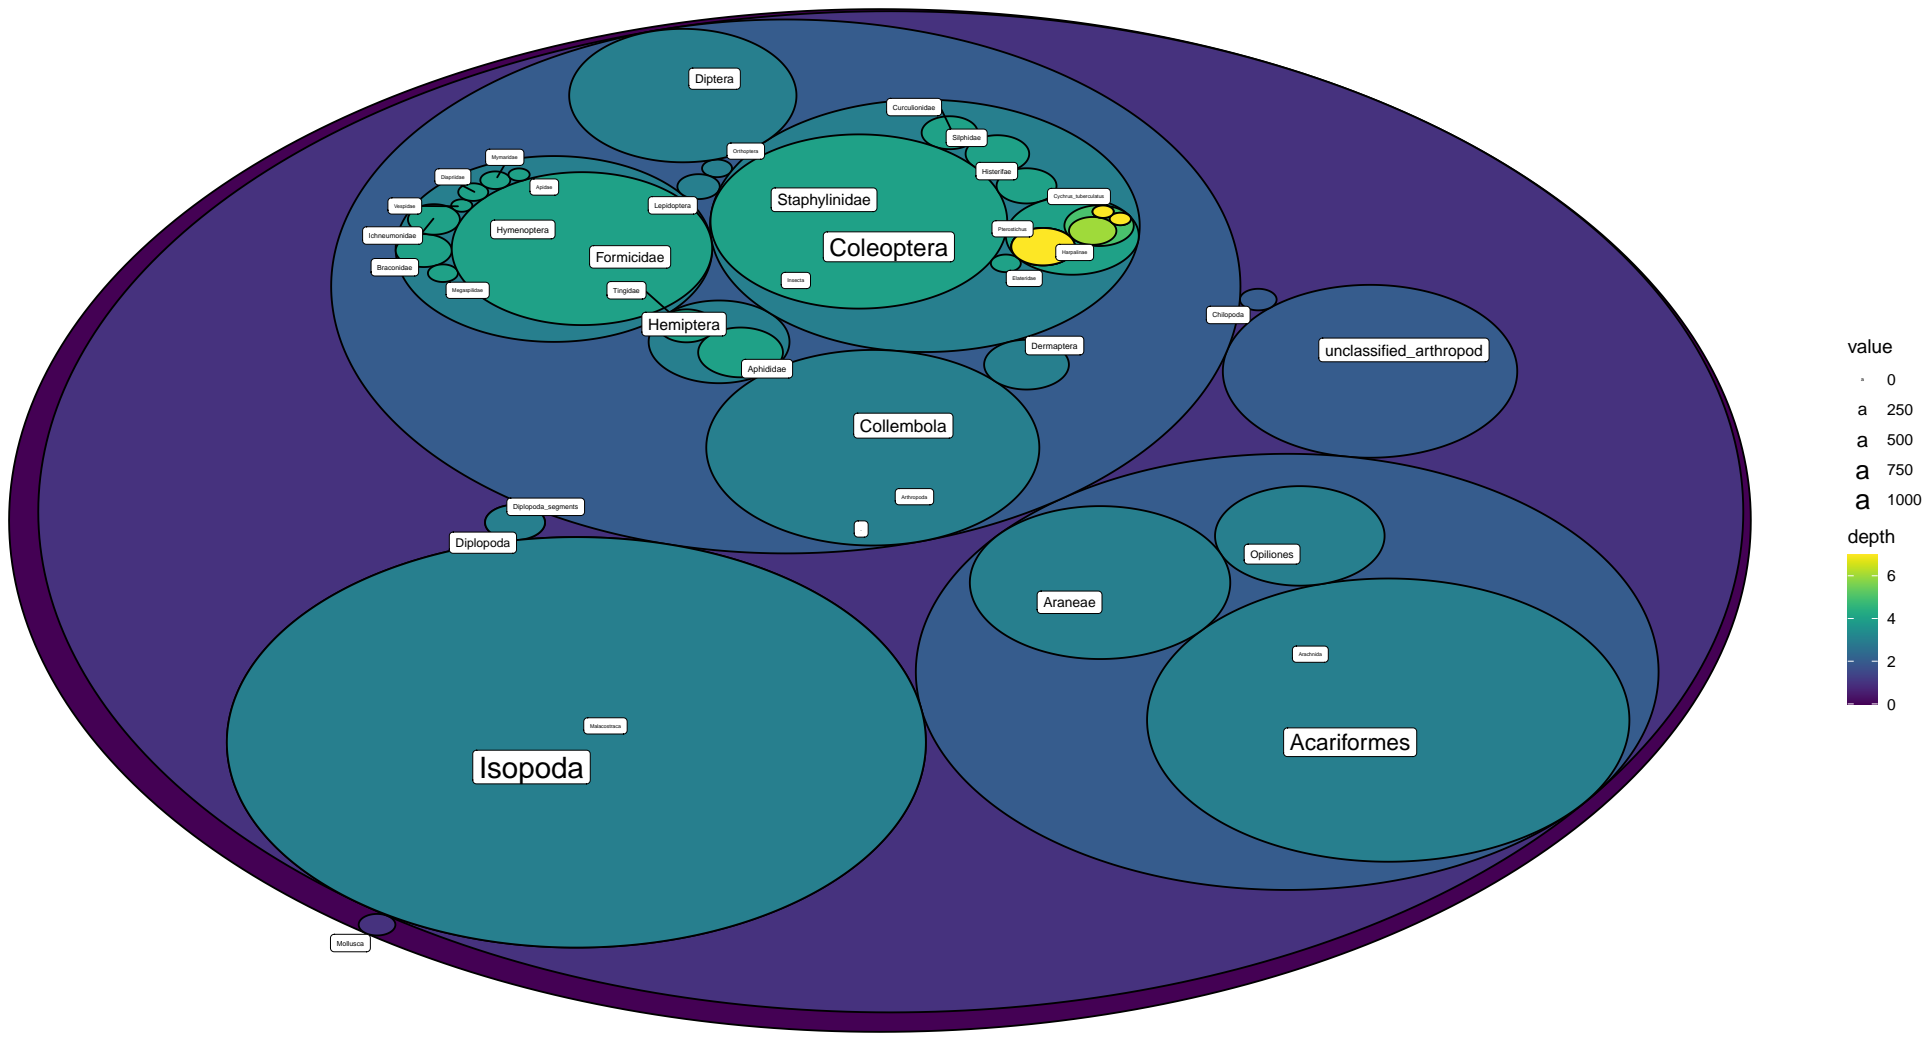
[picture p4: page 1]
Mollusca; Arthropoda; Diplopoda; unclassified_arthropod; Chilopoda; Arachnida; Malacostraca; Insecta; Diplopoda_segments; Acariformes; Opiliones; Araneae; Isopoda; Orthoptera; Hemiptera; Coleoptera; Diptera; Collembola; Dermaptera; Vespidae; Braconidae; Megaspilidae; Ichneumonidae; Formicidae; Diapriidae; Mymaridae; Apidae; Aphididae; Tingidae; Curculionidae; Silphidae; Staphylinidae; Histerifae; Elateridae; Harpalinae; Pterostichus; Cychrus_tuberculatus; value; depth
