chevalierid/alan-setup/prog/refactored/plots/interp_test.pdf

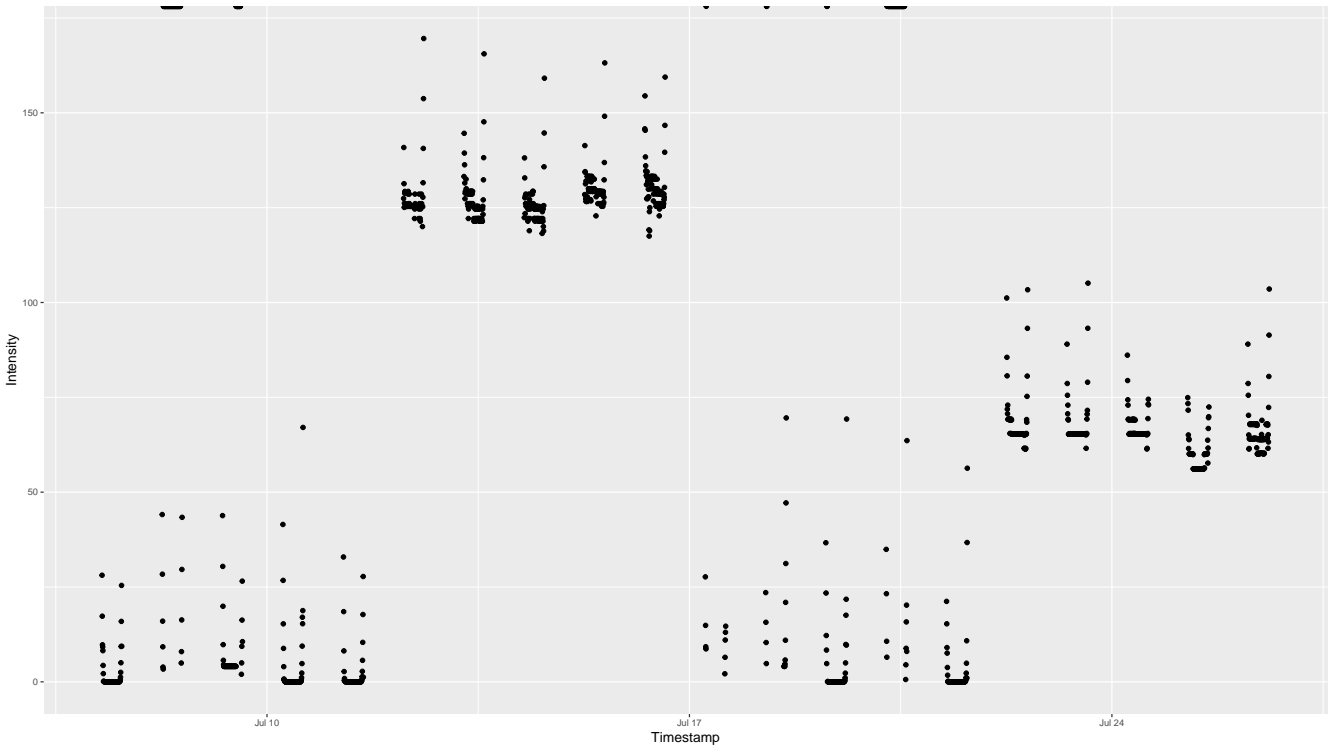
[picture p5: page 1]
Jul 10; Jul 17; Jul 24; Timestamp; Intensity
