chevalierid/alan-setup/prog/refactored/plots/changepoints-10.pdf

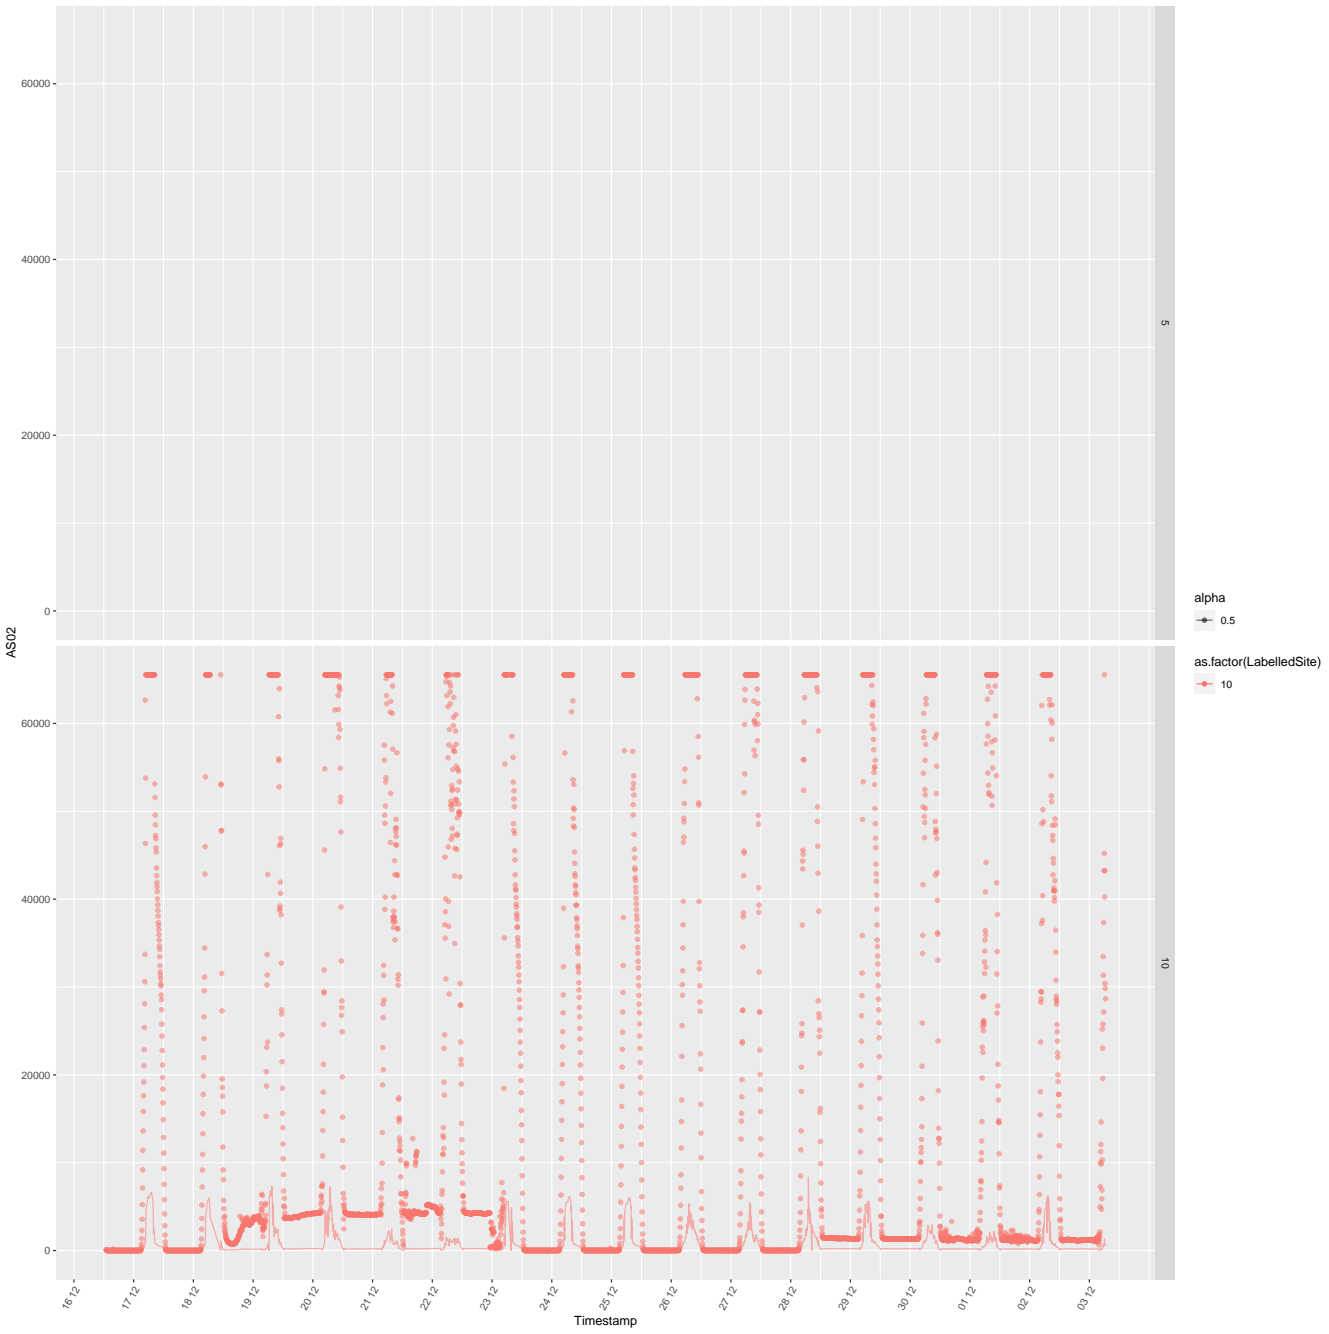
[picture p6: page 1]
Timestamp; alpha

as.factor(LabelledSite)
