chevalierid/alan-setup/prog/refactored/plots/changepoints-2.pdf

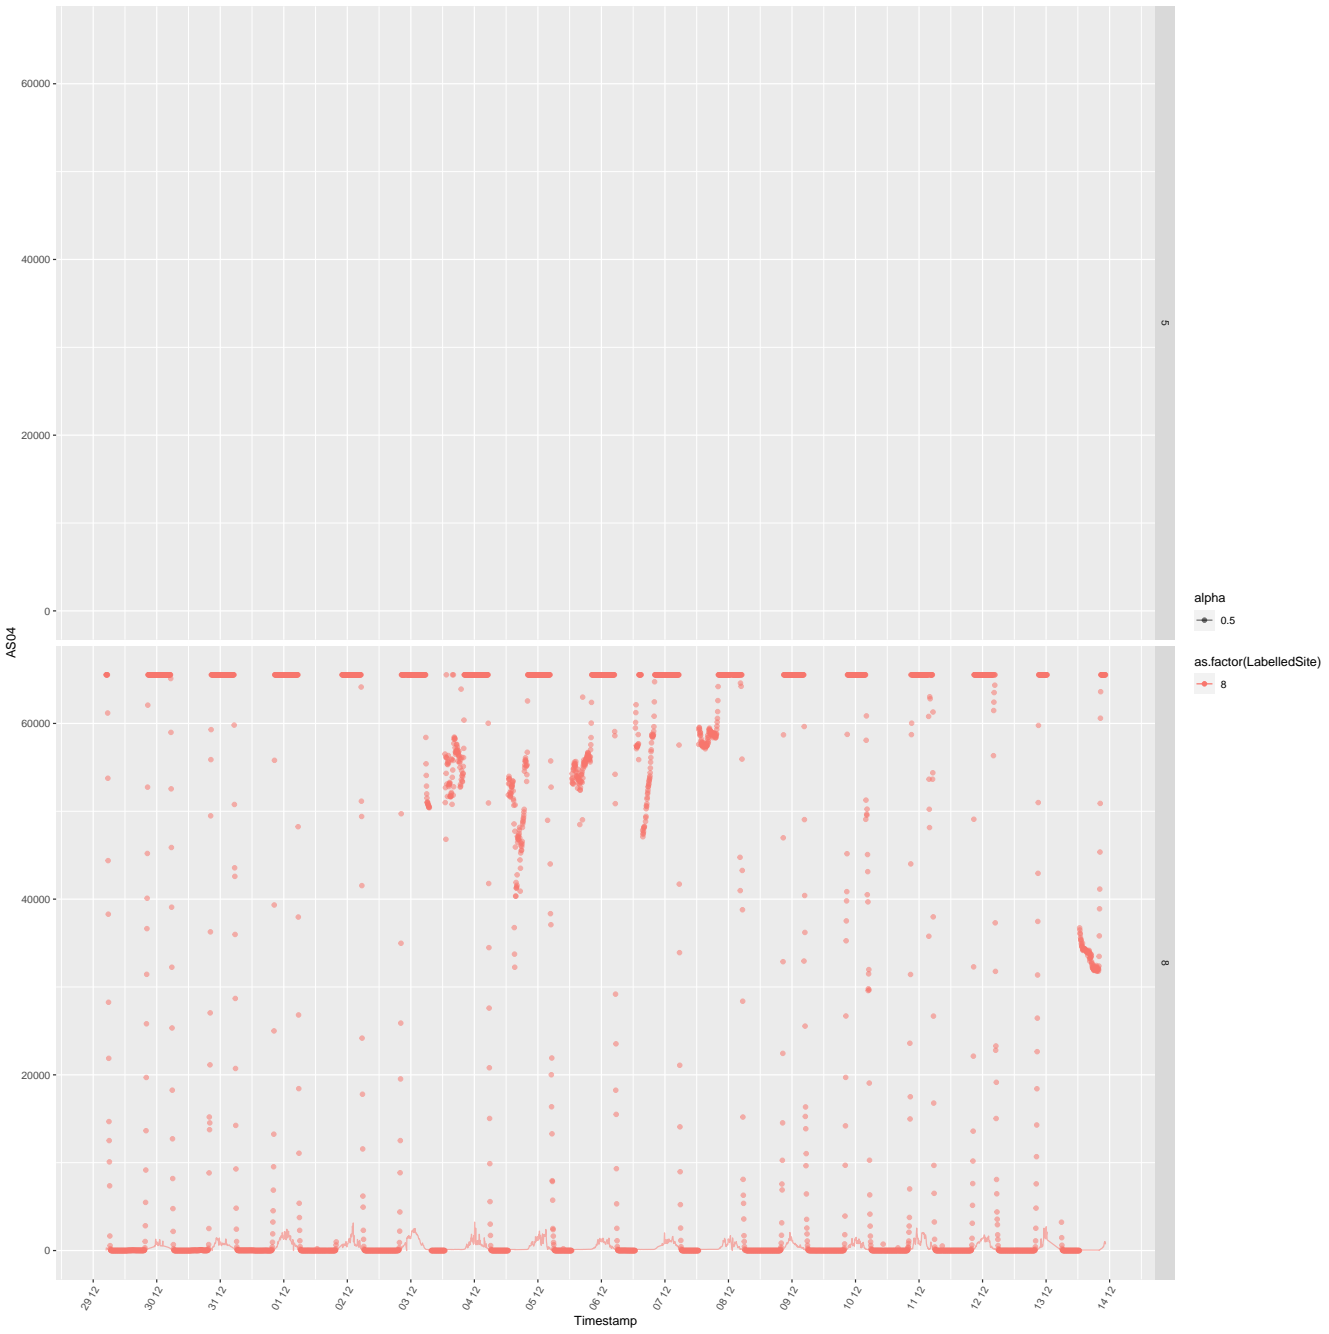
[picture p7: page 1]
Timestamp; alpha

as.factor(LabelledSite)
