chevalierid/alan-setup/prog/refactored/plots/changepoints-8.pdf

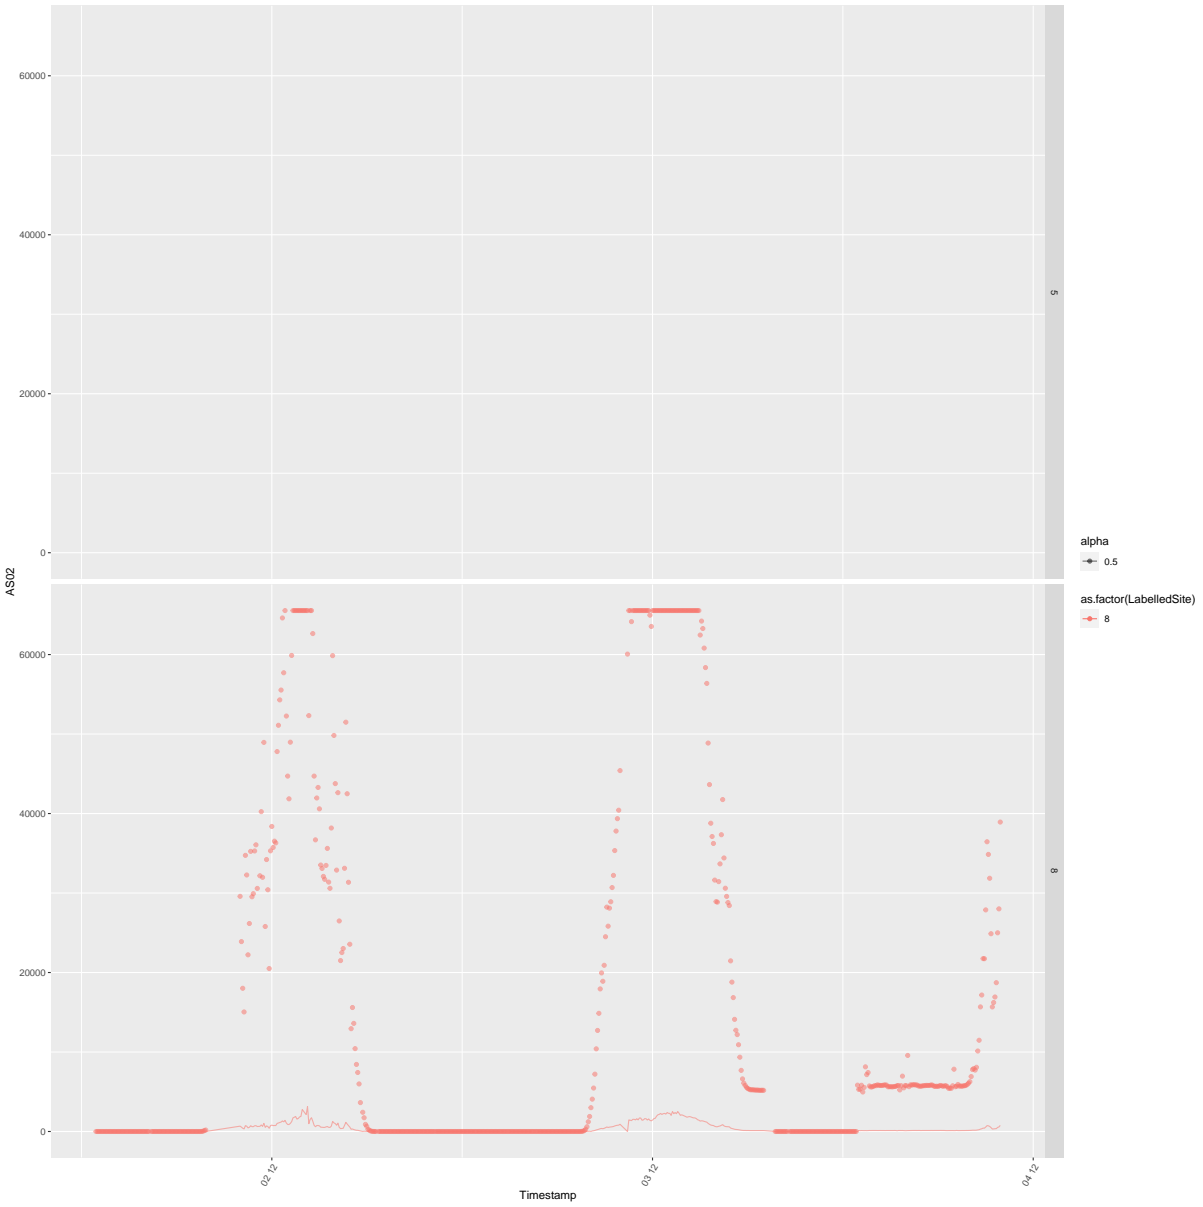
[picture p8: page 1]
Timestamp; alpha

as.factor(LabelledSite)
