chevalierid/alan-setup/prog/refactored/plots/biomass_all_points.pdf

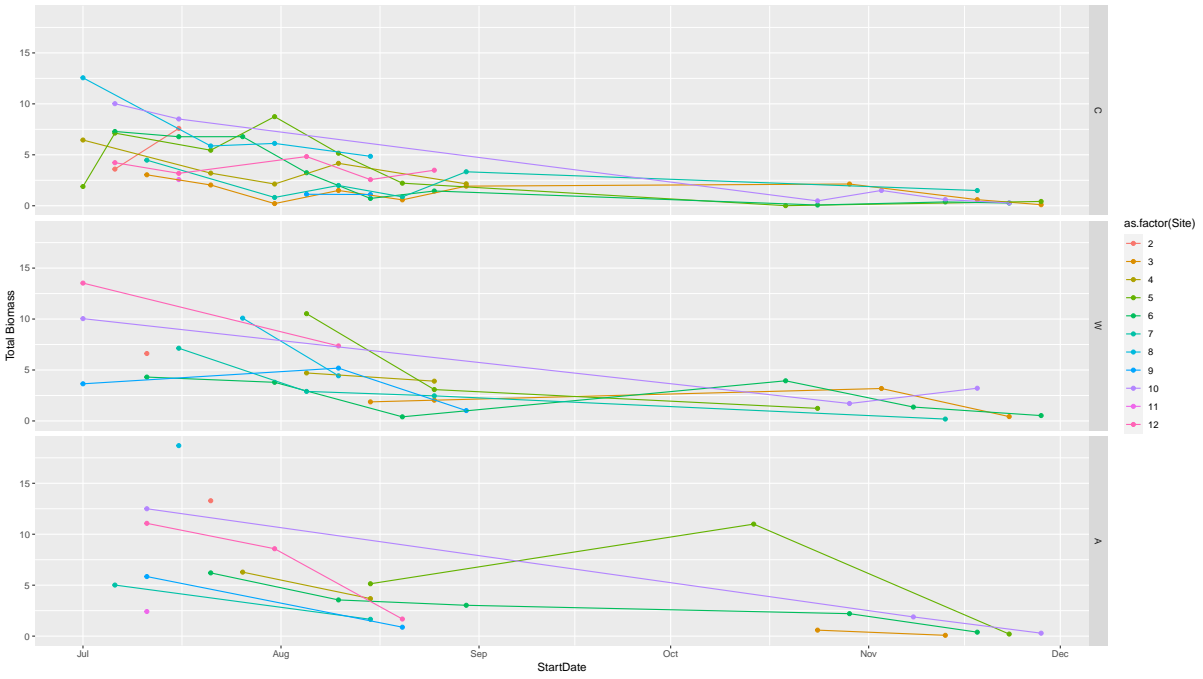
[picture p9: page 1]
Jul; Aug; Sep; Oct; Nov; Dec; StartDate; Total Biomass

as.factor(Site) 23456789
