chevalierid/alan-setup/prog/refactored/plots/biomass_points_stat.pdf

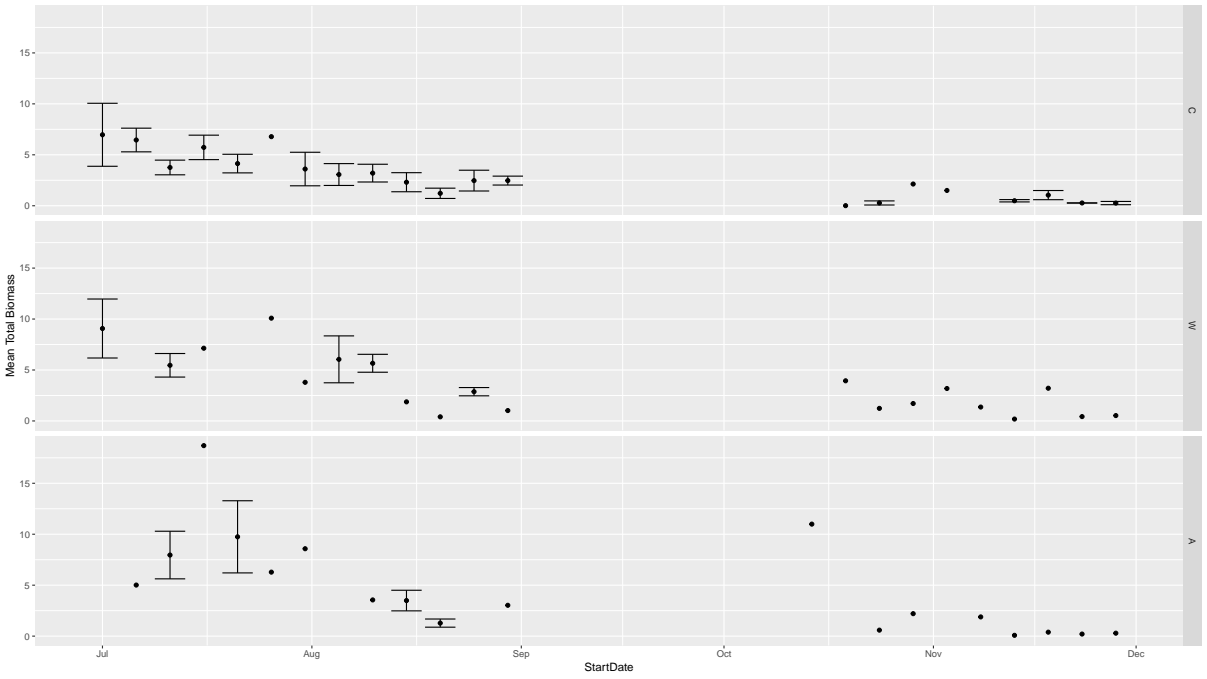
[picture p10: page 1]
Jul; Aug; Sep; Oct; Nov; Dec; StartDate

Mean Total Biomass
