chevalierid/alan-setup/prog/refactored/plots/changepoints-12.pdf

## alpha

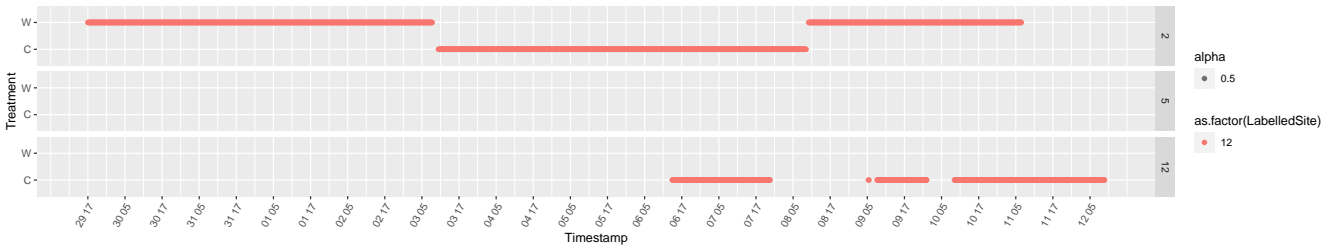
[picture p11: page 1]
CWCWCW; Timestamp; Treatment

as.factor(LabelledSite)
