chevalierid/alan-setup/prog/refactored/plots/changepoints-4.pdf

## alpha

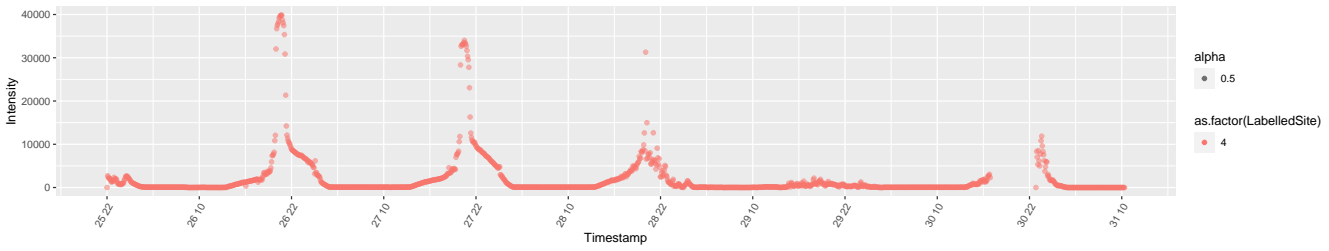
[picture p12: page 1]
Timestamp; Intensity

as.factor(LabelledSite) 4
