chevalierid/alan-setup/prog/refactored/plots/changepoints-find.pdf

## alpha

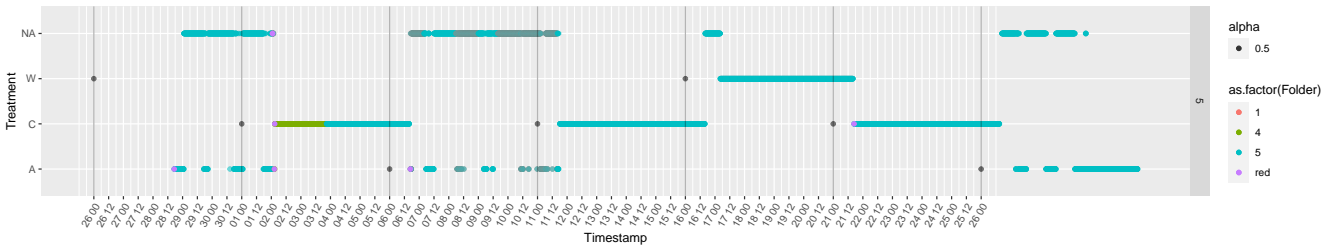
[picture p13: page 1]
Timestamp; Treatment; red

as.factor(Folder)
