chevalierid/alan-setup/prog/refactored/plots/changepoints-x-changed.pdf

## alpha

## as.factor(LabelledSite)

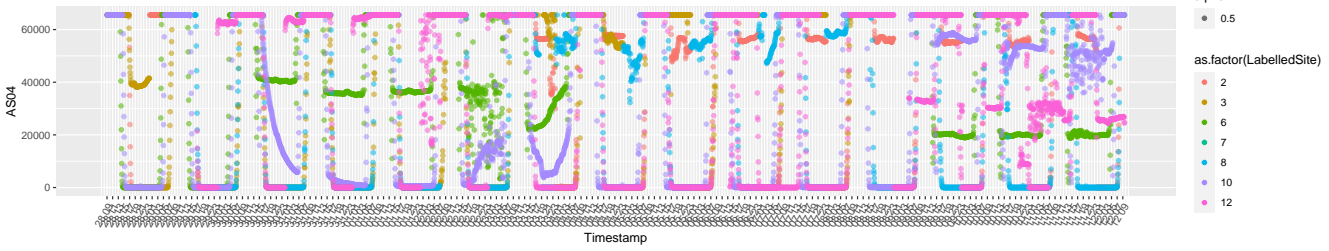
[picture p14: page 1]
Timestamp
