chevalierid/alan-setup/prog/refactored/plots/changepoints-x.pdf

## alpha

## as.factor(LabelledSite)

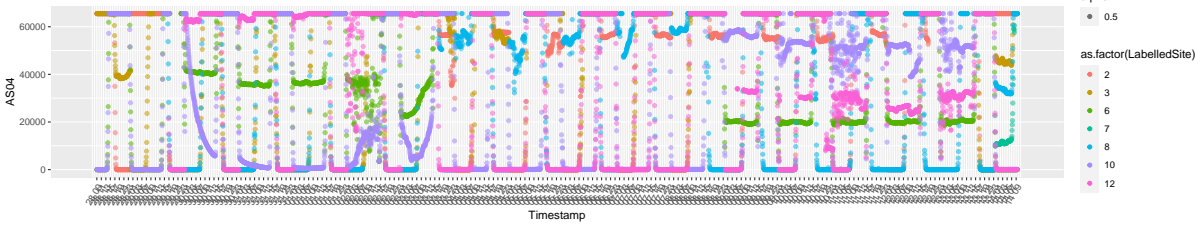
[picture p15: page 1]
Timestamp
