chevalierid/alan-setup/prog/refactored/plots/changepoints-zoom-in.pdf

## alpha

## as.factor(LabelledSite) 2368

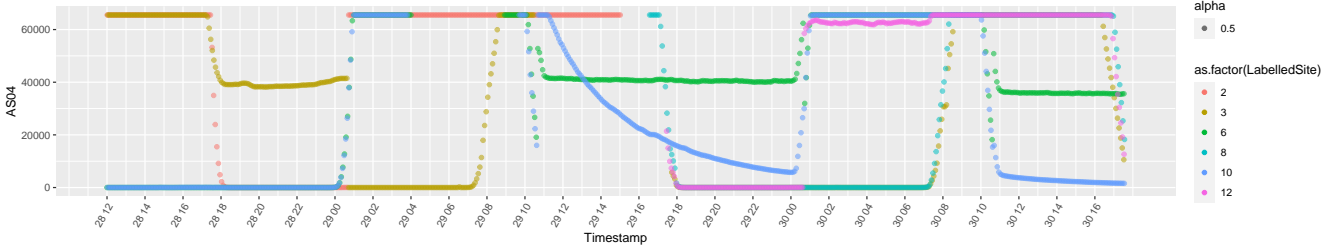
[picture p16: page 1]
Timestamp
