chevalierid/alan-setup/prog/refactored/plots/changepoints2.pdf

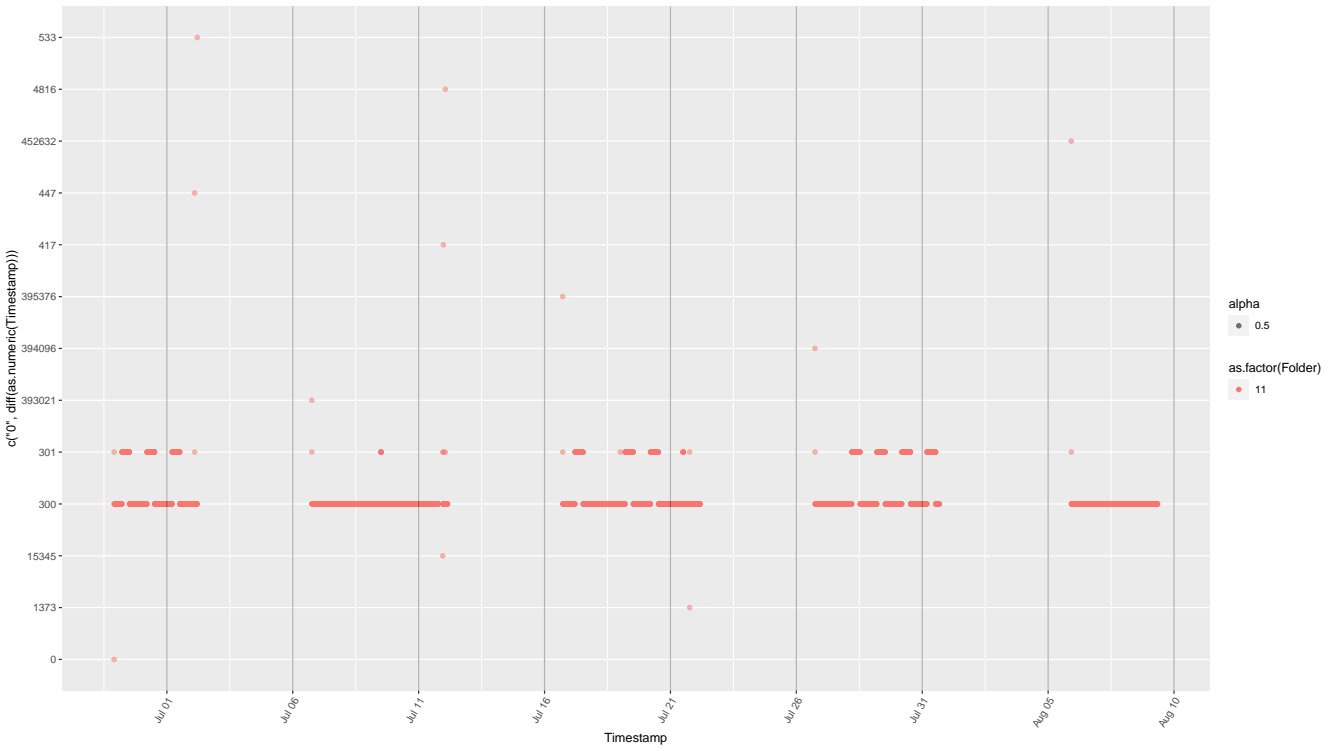
[picture p17: page 1]
Jul 01; Jul 06; Jul 11; Jul 16; Jul 21; Jul 26; Jul 31; Aug 05; Aug 10; Timestamp; alpha

c("0", diff(as.numeric(Timestamp)))

as.factor(Folder)
