chevalierid/alan-setup/prog/refactored/plots/hierarch_vis_by_treatments.pdf

# Diplopoda

### Dermaptera

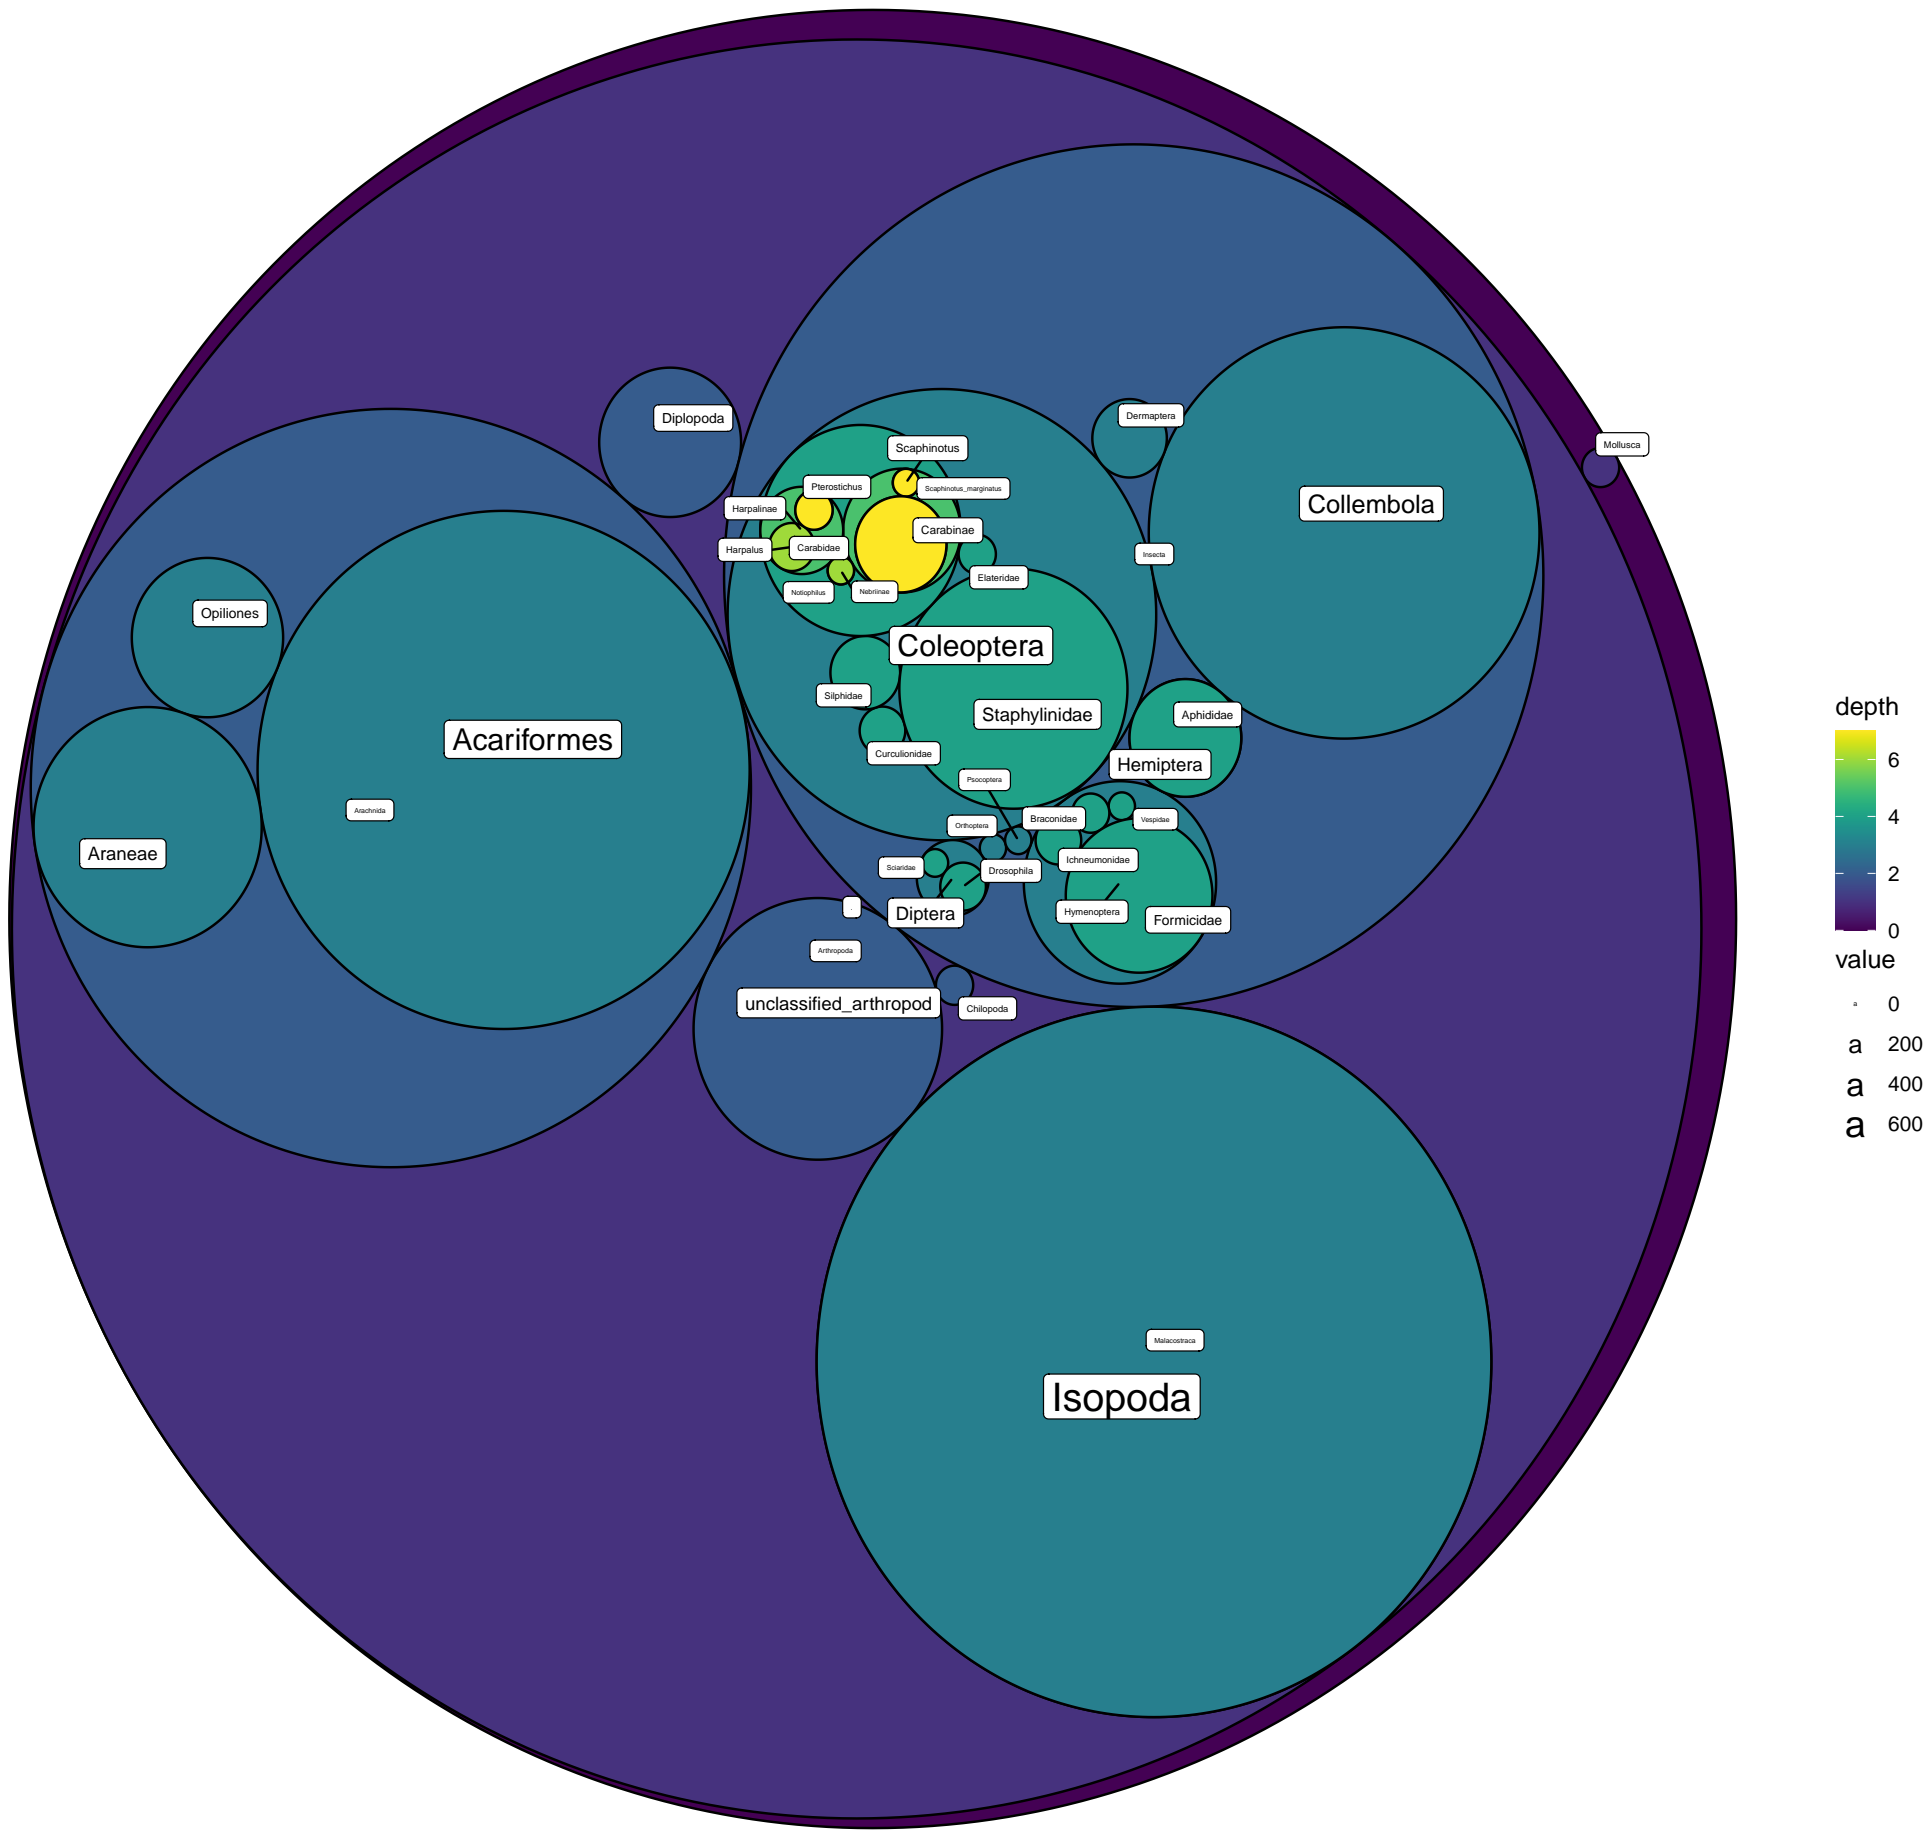
[picture p18: page 2]
Mollusca; Arthropoda; unclassified_arthropod; Chilopoda; Arachnida; Malacostraca; Insecta; Acariformes; Opiliones; Araneae; Isopoda; Orthoptera; Hymenoptera; Hemiptera Psocoptera; Coleoptera; Diptera; Collembola; Braconidae; Vespidae; Ichneumonidae; Formicidae; Aphididae; Curculionidae; Silphidae; Staphylinidae; Carabidae; Elateridae; Sciaridae; Drosophila; Carabinae; Harpalinae; Notiophilus; Nebriinae; Scaphinotus; Pterostichus; Harpalus; Scaphinotus_marginatus; depth; value

# Araneae

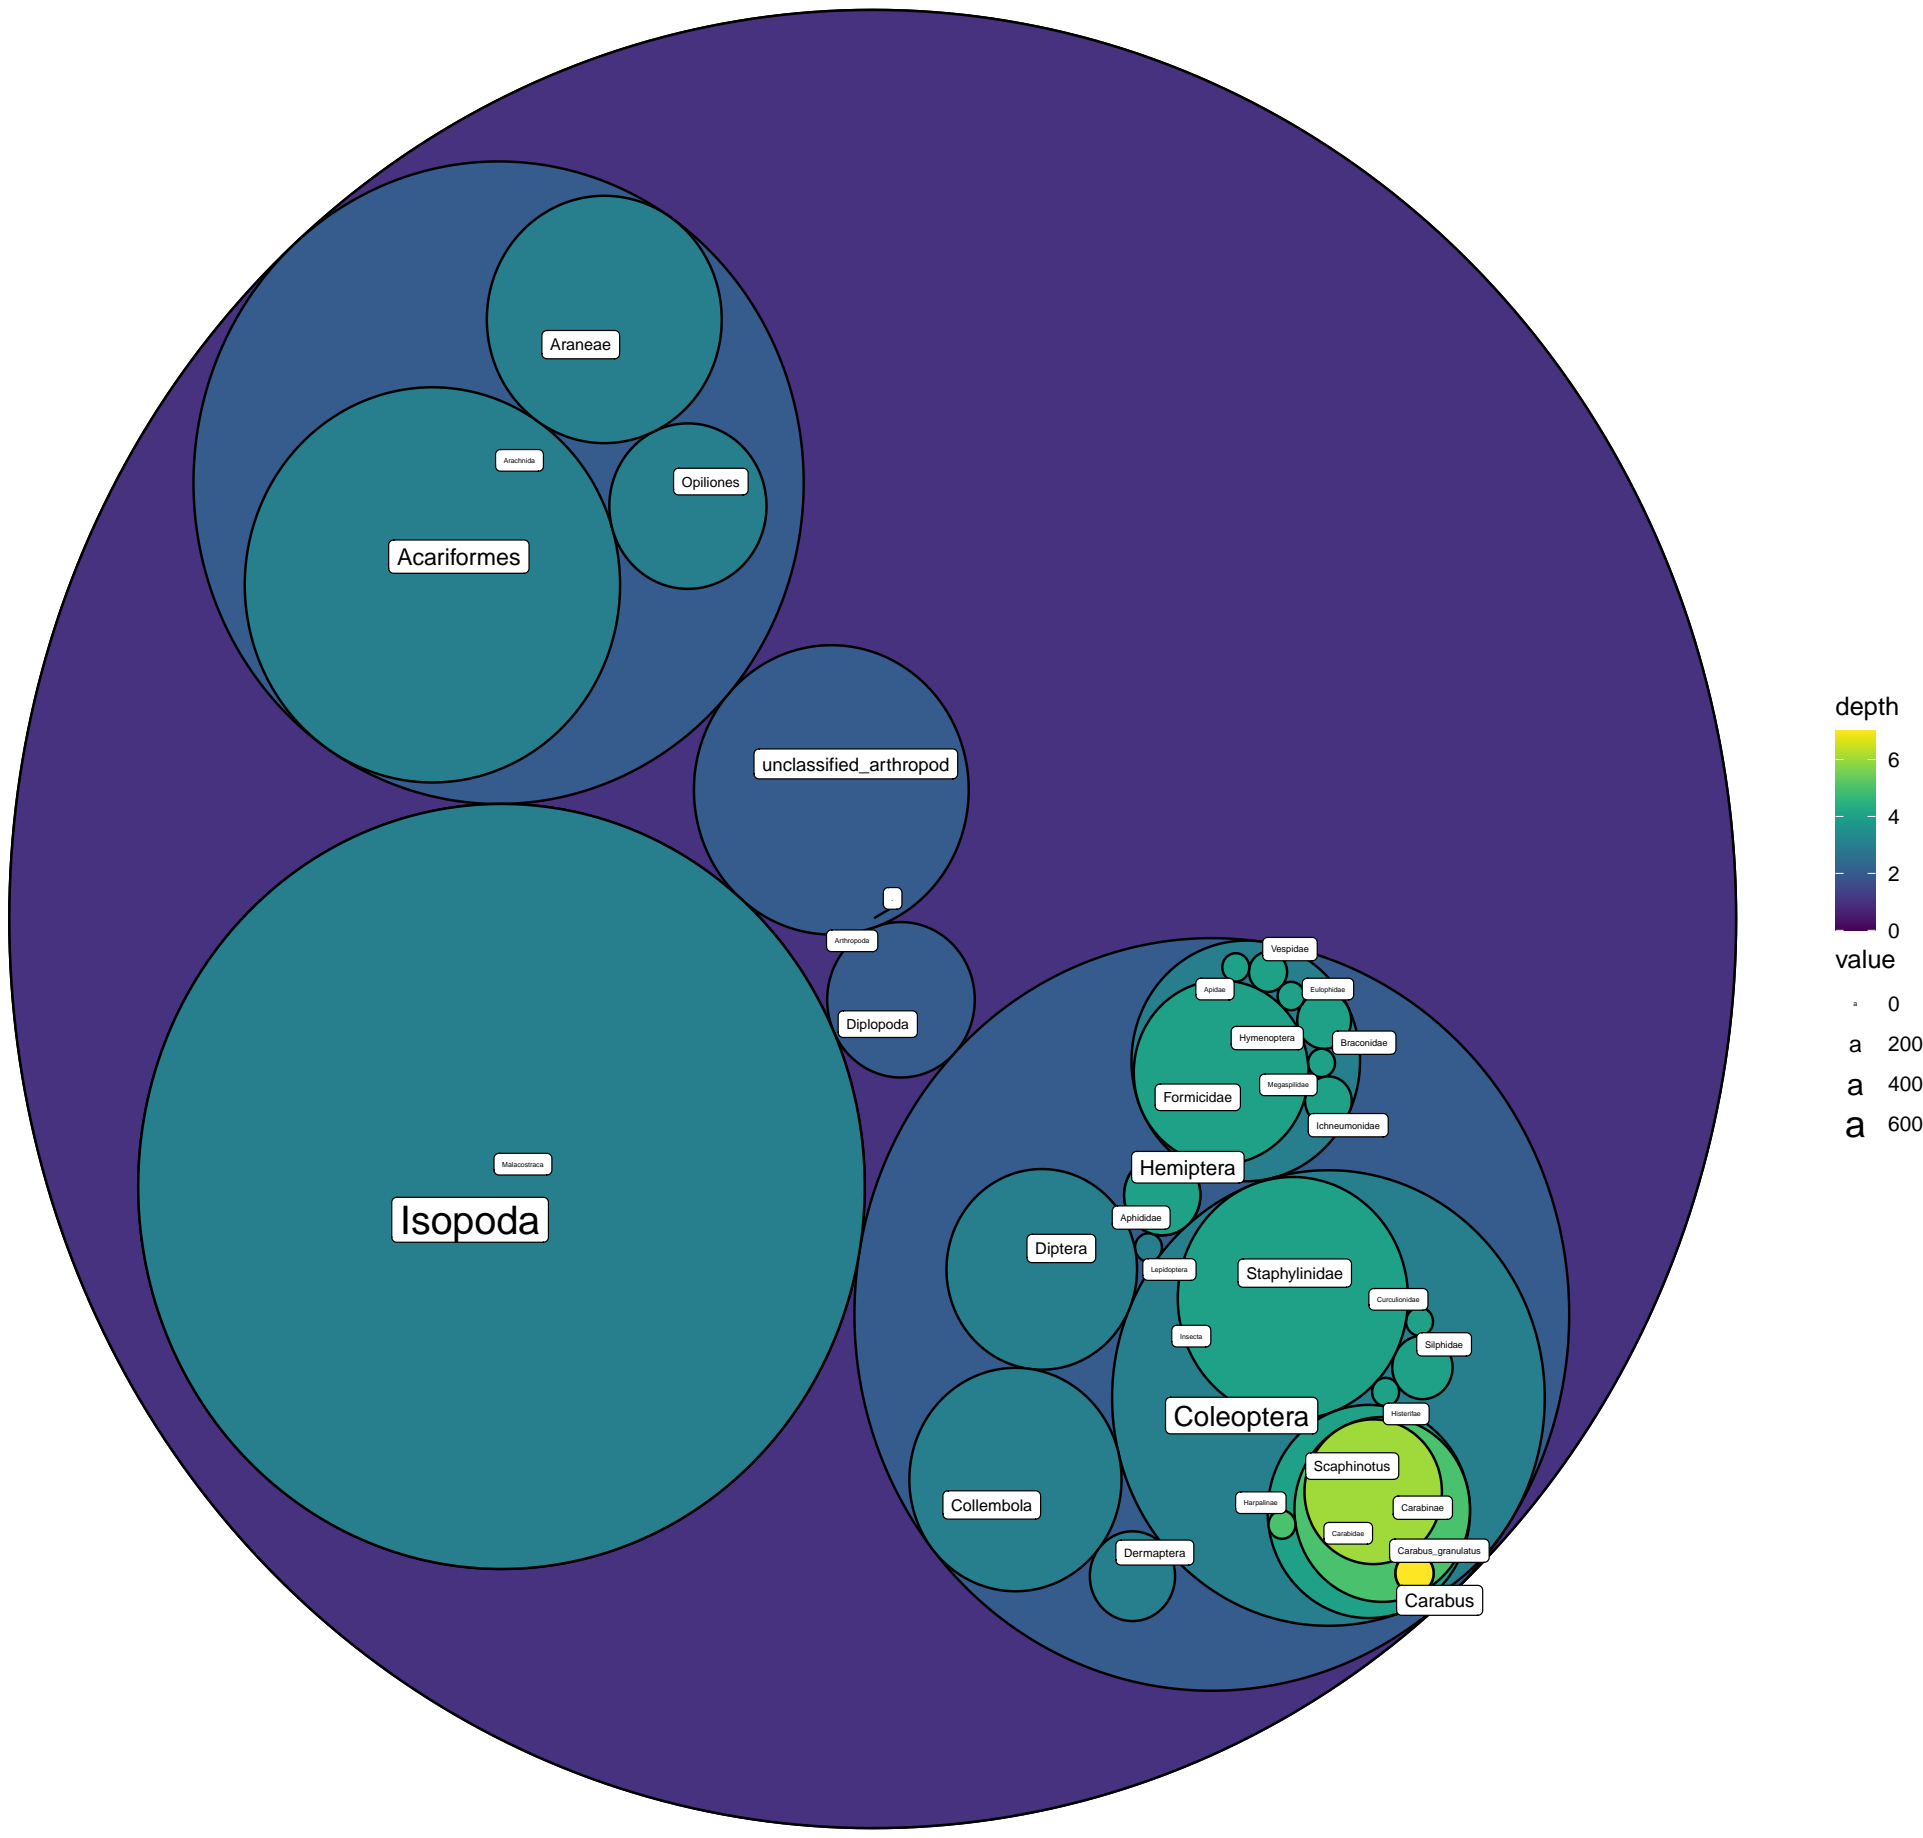
[picture p19: page 3]
Arthropoda; Diplopoda; unclassified_arthropod; Arachnida; Malacostraca; Insecta; Acariformes; Opiliones; Isopoda; Hymenoptera; Hemiptera; Lepidoptera; Coleoptera; Diptera; Collembola; Dermaptera; Vespidae; Braconidae; Eulophidae; Megaspilidae; Ichneumonidae; Formicidae; Apidae; Aphididae; Curculionidae; Silphidae; Staphylinidae; Histerifae; Carabidae; Carabinae Harpalinae; Scaphinotus; Carabus; Carabus_granulatus; depth; value
