chevalierid/alan-setup/prog/refactored/plots/interp.pdf

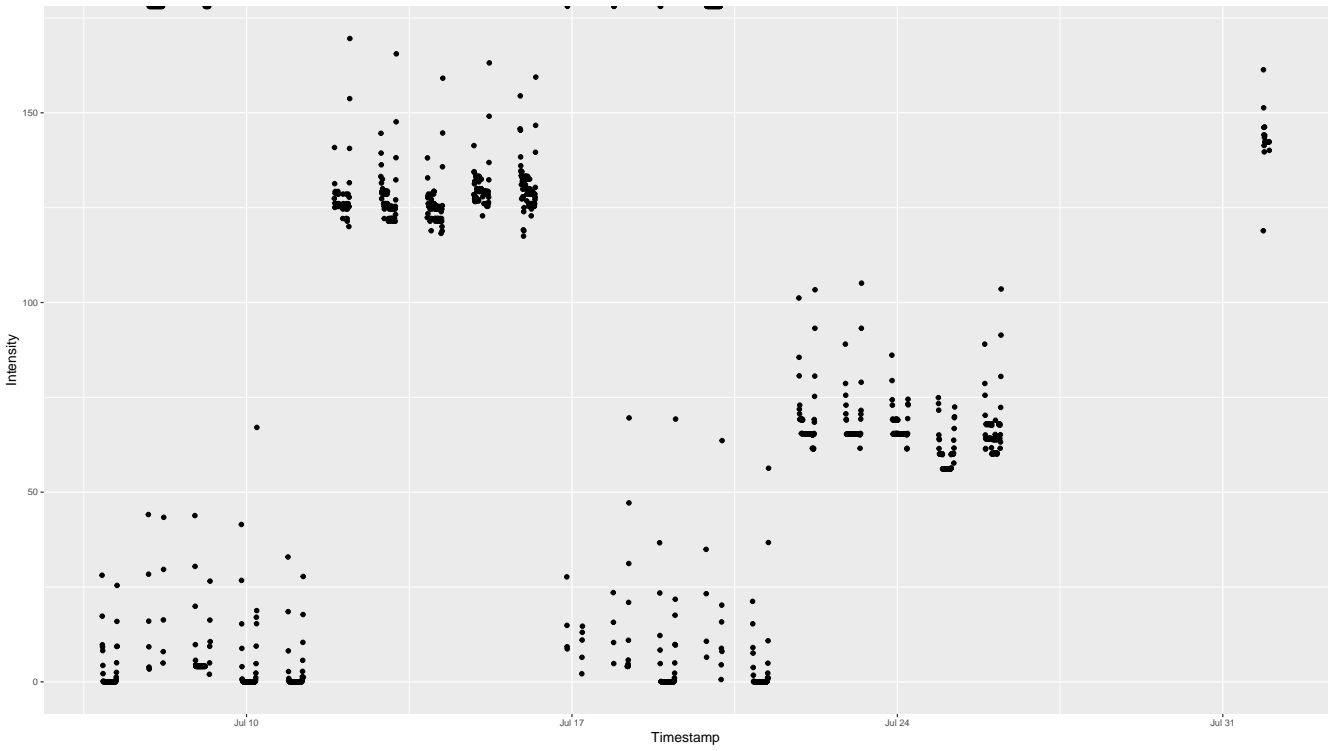
[picture p20: page 1]
Jul 10; Jul 17; Jul 24; Jul 31; Timestamp; Intensity
