chevalierid/alan-setup/prog/refactored/plots/treatments.pdf

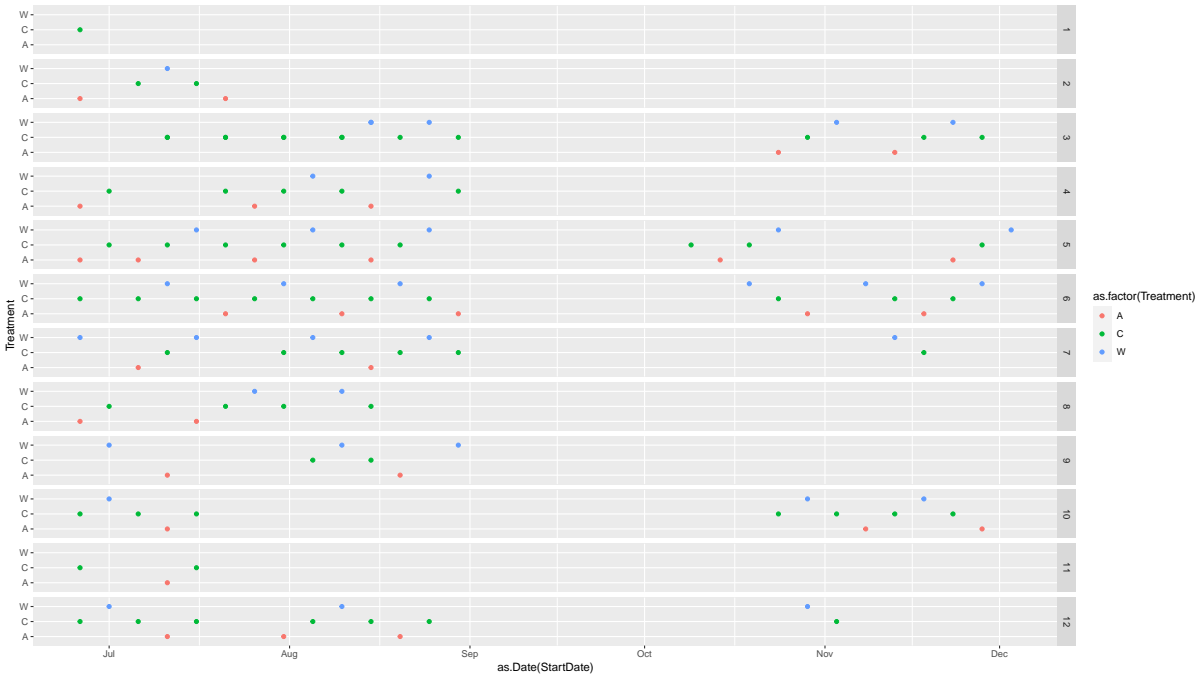
[picture p21: page 1]
Jul; Aug; Sep; Oct; Nov; Dec; ACWACWACWACWACWACWACWACWACWACWACWACW; Treatment

as.factor(Treatment) ACW

as.Date(StartDate)
