chevalierid/alan-setup/prog/refactored/scripts/interp.pdf

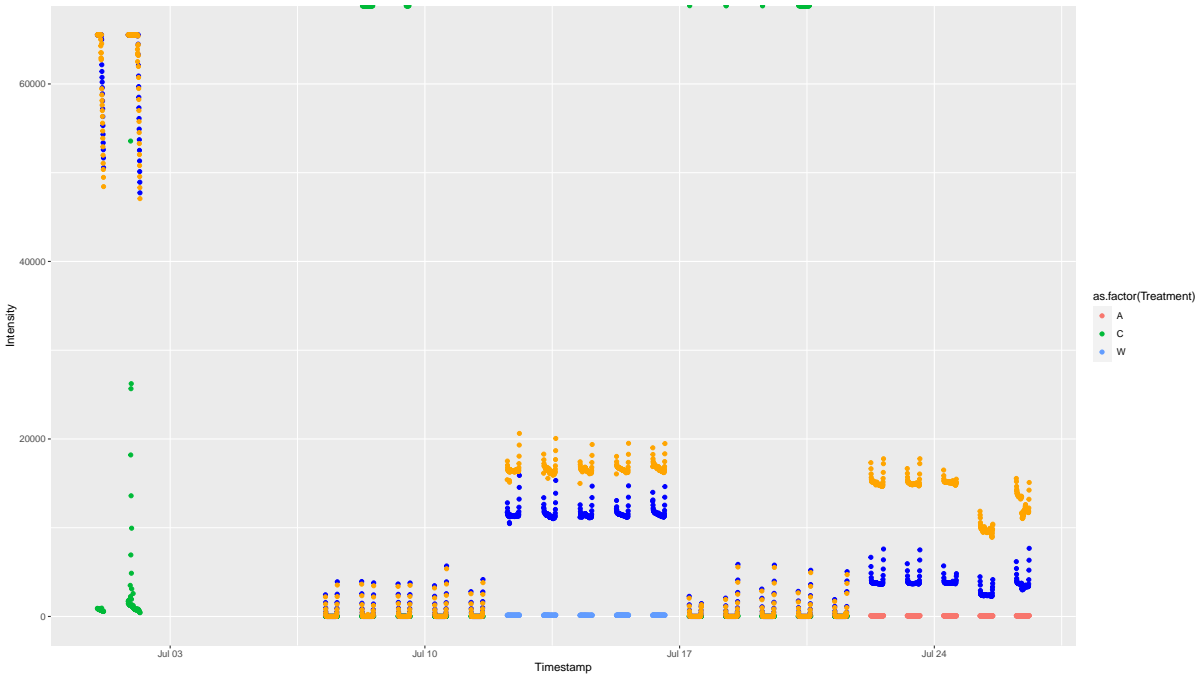
[picture p22: page 1]
Jul 03; Jul 10; Jul 17; Jul 24; Timestamp; Intensity

as.factor(Treatment)
