chevalierid/alan-setup/fab/kicad/controller_pcb/controller_pcb.kicad_pcb

## KiCad design fab/kicad/controller_pcb/controller_pcb.kicad_pcb (2024-04-19)

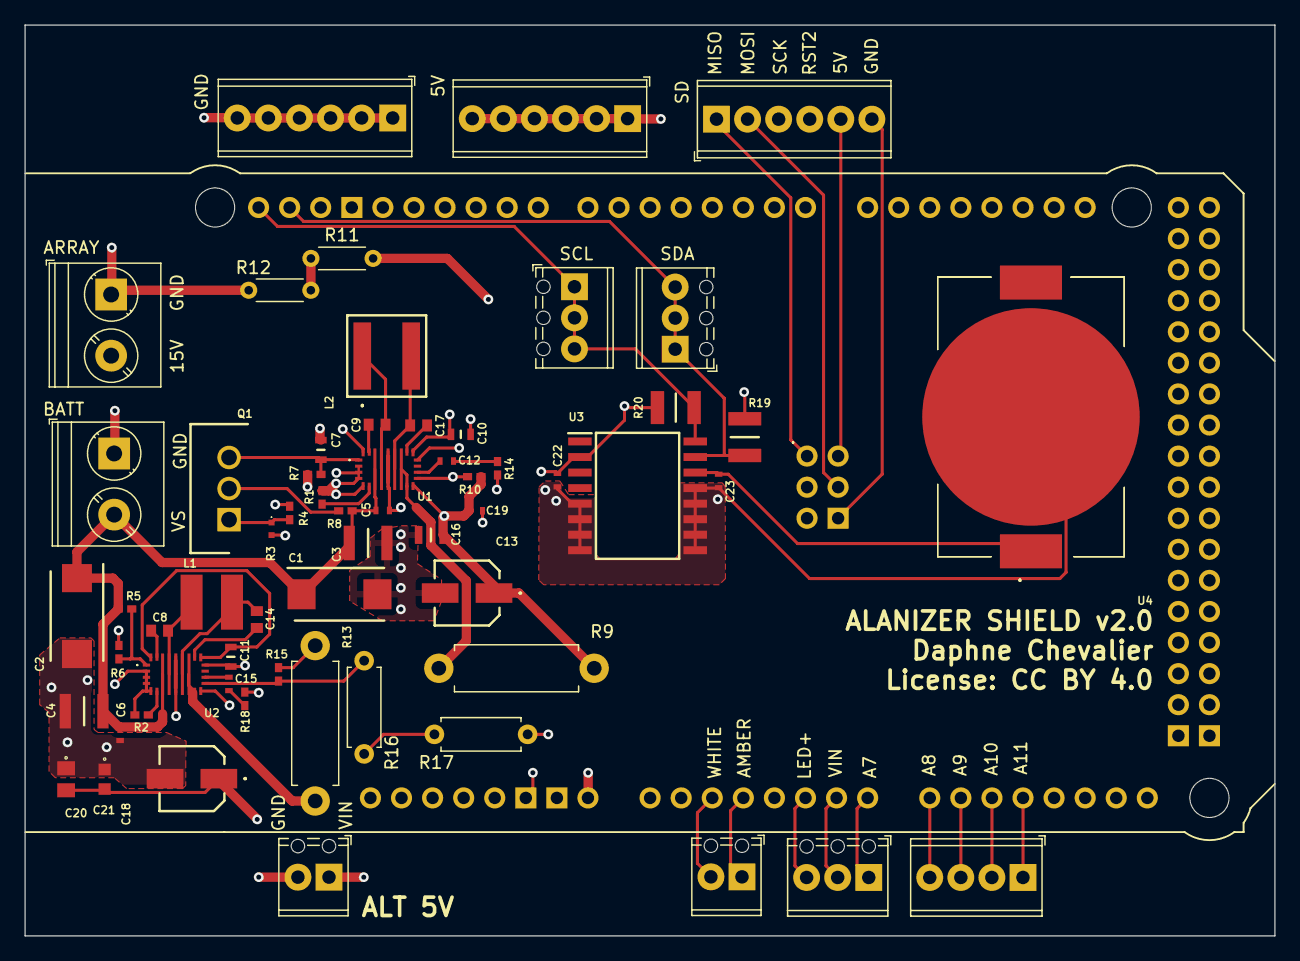
[picture p23: board controller_pcb.kicad_pcb from above]

Board: 4 copper layers, 102.2 x 74.4 mm, 62 parts (0 on the bottom side), 49 nets.

Parts:
A1: Arduino_Mega2560_R3_Shield; mega_modified
C1, C2: EEFCX1E330R; CAPPM7343X200N
C3, C4: C3225X7R1H106M250AC; CAPC3225X230N
C5, C6, C19: C1005X5R1V105K050BC; CAPC1005X55N
C7, C10, C11: C1608X6S1C475K080AC; CAPC1608X80N
C8, C9, C14, C17: EMK107B7104KA-T; CAPC1608X95N
C12, C22, C23: GRM155R70J104KA01D; CAPC1005X55N
C13: 25SVPF27MX; 16SVF82M
C15: GRM155R70J473KA01D; CAPC1005X55N
C16: C2012X5R1V156M125AC; CAPC2012X145N
C18: 10SVPC68MV; 16SVF82M
C20: C0805C106K8PACTU; C0805
C21: C0603C105Z8VACTU; C0603
J1: Screw_Terminal_01x04; TerminalBlock_Phoenix_MPT-0,5-4-2.54_1x04_P2.54mm_Horizontal
J2, J3, J4: Screw_Terminal_01x03; TerminalBlock_Phoenix_MPT-0,5-3-2.54_1x03_P2.54mm_Horizontal
J5, J6, J11: Screw_Terminal_01x06; TerminalBlock_Phoenix_MPT-0,5-6-2.54_1x06_P2.54mm_Horizontal
J7, J9: Screw_Terminal_01x02; TerminalBlock_Phoenix_MPT-0,5-2-2.54_1x02_P2.54mm_Horizontal
J8, J10: 1935161; TerminalBlock_Phoenix_PT-1,5-2-5.0-H_1x02_P5.00mm_Horizontal
L1: SDR0403-4R7ML; SDR0403
L2: 74439346100
Q1: IRLZ44N; TO254P469X1042X1967-3P
R1, R2: CRCW040248K7FKED; RESC1005X40N
R3: ERJ-2RKF2400X; ERJ2RKD1004X
R4: CRCW040210K0FKED; RESC1005X40N
R5, R8: CRCW0402301KFKED; RESC1005X40N
R6, R7, R10, R15: CRCW0402100KFKED; RESC1005X40N
R9, R13: WLBR050FET; R_Axial_DIN0411_L9.9mm_D3.6mm_P12.70mm_Horizontal
R11: CFM14JT8K20; R_Axial_DIN0204_L3.6mm_D1.6mm_P5.08mm_Horizontal
R12: MBA02040C7320FRP00; R_Axial_DIN0204_L3.6mm_D1.6mm_P5.08mm_Horizontal
R14: CRCW0402301RFKED; RESC1005X40N
R16: RN55D3202FB14; R_Axial_DIN0207_L6.3mm_D2.5mm_P7.62mm_Horizontal
R17: CF14JT620R; R_Axial_DIN0207_L6.3mm_D2.5mm_P7.62mm_Horizontal
R18: CRCW040213K0FKED; RESC1005X40N
R19, R20: CRCW12104K70JNEA; RESC3225X60N
U1, U2: TPS55289RYQR; TPS552892QWRYQRQ1
U3: DS3231SN; SOIC127P1032X265-16N
U4: BK-912-TR; BK912TR

Connections:
A4: A1.A4, R3.2
BATT+: C1.1 (K), C2.1 (K), C3.2, C4.2, C5.2, C6.2, J10.2, R5.2, R8.2, U1.7 (VIN), U2.7 (VIN)
BOOT1: C9.1, U1.20 (BOOT1)
BOOT1-2: C8.1, U2.20 (BOOT1)
BOOT2: C17.1, U1.19 (BOOT2)
BOOT2-2: C14.1, U2.19 (BOOT2)
GND: A1.GND2 (GND), C1.2, C2.2, C3.1, C4.1, C5.1, C6.1, C7.1, C10.1, C11.1, C13.2 (-), C16.1, C18.2 (-), C19.1, C20.1, C21.1, C22.1, C23.1, J5.1, J5.2, J5.3, J5.4, J5.5, J5.6, J7.2, J8.1, J10.1, R1.1, R2.1, R4.1, R6.1, R7.1, R12.1, R14.1, R17.1, R18.1, U1.2 (MODE), U1.3 (SCL), U1.4 (SDA), U1.5 (DITH/SYNC), U1.9 (PGND_1), U1.17 (AGND), U1.22 (PGND_2), U1.23 (PGND_3), U2.2 (MODE), U2.3 (SCL), U2.4 (SDA), U2.5 (DITH/SYNC), U2.9 (PGND_1), U2.17 (AGND), U2.22 (PGND_2), U2.23 (PGND_3), U3.5 (N.C._1), U3.6 (N.C._2), U3.7 (N.C._3), U3.8 (N.C._4), U3.9 (N.C._5), U3.10 (N.C._6), U3.11 (N.C._7), U3.12 (N.C._8), U3.13 (GND), U4.3 (-)
unnamed: A1.5V2 (SPI_5V), J11.5
unnamed: A1.A2, J9.2
unnamed: A1.A3, J9.1
unnamed: A1.A5, J2.3
unnamed: A1.A6, J2.2
unnamed: A1.A7, J2.1
unnamed: A1.A8, J1.4
unnamed: A1.A9, J1.3
unnamed: A1.A10, J1.2
unnamed: A1.A11, J1.1
unnamed: A1.GND4 (SPI_GND), J11.6
unnamed: A1.MISO (SPI_MISO), J11.1
unnamed: A1.MOSI (SPI_MOSI), J11.2
unnamed: A1.RST2 (SPI_RESET), J11.4
unnamed: A1.SCK (SPI_SCK), J11.3
unnamed: C7.2, Q1.3 (S), R7.2, U1.1 (EN/UVLO)
unnamed: C10.2, U1.18 (VCC), U1.21 (EXTVCC)
unnamed: C11.2, U2.18 (VCC), U2.21 (EXTVCC)
unnamed: C12.1, R14.2
unnamed: C12.2, U1.15 (COMP)
unnamed: C15.1, R18.2
unnamed: C15.2, U2.15 (COMP)
unnamed: C23.2, U3.14 (VBAT), U4.1 (+_1)
unnamed: Q1.1 (G), R3.1, R4.2
unnamed: Q1.2 (D), R8.1
unnamed: R1.2, U1.6 (FSW)
unnamed: R2.2, U2.6 (FSW)
unnamed: R5.1, R6.2, U2.1 (EN/UVLO)
unnamed: R9.2, U1.11 (VOUT), U1.12 (ISP)
unnamed: R10.1, R11.2, U1.14 (FB/~INT)
unnamed: R11.1, R12.2
unnamed: R13.2, U2.11 (VOUT), U2.12 (ISP)
unnamed: R15.1, R16.2, U2.14 (FB/~INT)
unnamed: R16.1, R17.2
SCL: A1.SCL, J3.1, J3.2, J3.3, R20.1, U3.16 (SCL)
SDA: A1.SDA, J4.1, J4.2, J4.3, R19.1, U3.15 (SDA)
SW1: C9.2, L2.1, U1.8 (SW1)
SW1-2: C8.2, L1.1, U2.8 (SW1)
SW2: C17.2, L2.2, U1.10 (SW2)
SW2-2: C14.2, L1.2, U2.10 (SW2)
V5+: A1.VIN, C18.1 (+), C20.2, C21.2, C22.2, J6.1, J6.2, J6.3, J6.4, J6.5, J6.6, J7.1, R13.1, R15.2, R19.2, R20.2, U2.13 (ISN), U3.2 (VCC)
V15+: C13.1 (+), C16.2, C19.2, J8.2, R9.1, R10.2, U1.13 (ISN)
