chevalierid/alan-setup/prog/portable_lightmeter/portable_lightmeter.ino

/*********************

Example code for the Adafruit RGB Character LCD Shield and Library

This code displays text on the shield, and also reads the buttons on the keypad.
When a button is pressed, the backlight changes color.

**********************/

// include the library code:
#include <Wire.h>
#include <Adafruit_RGBLCDShield.h>
#include <utility/Adafruit_MCP23017.h>
#include <Adafruit_Sensor.h>
#include "Adafruit_TSL2591.h"
#include <Adafruit_AS7341.h>


// The shield uses the I2C SCL and SDA pins. On classic Arduinos
// this is Analog 4 and 5 so you can't use those for analogRead() anymore
// However, you can connect other I2C sensors to the I2C bus and share
// the I2C bus.
Adafruit_RGBLCDShield lcd = Adafruit_RGBLCDShield();
Adafruit_AS7341 as7341;
Adafruit_TSL2591 tsl = Adafruit_TSL2591(2591); // pass in a number for the sensor identifier (for your use later)

// These #defines make it easy to set the backlight color
#define RED 0x1
#define YELLOW 0x3
#define GREEN 0x2
#define TEAL 0x6
#define BLUE 0x4
#define VIOLET 0x5
#define WHITE 0x7

uint16_t tsl_read;
bool screen_on;

void configureTSL(void)
{
  // You can change the gain on the fly, to adapt to brighter/dimmer light situations
  //tsl.setGain(TSL2591_GAIN_LOW);    // 1x gain (bright light)
  tsl.setGain(TSL2591_GAIN_MED);      // 25x gain
  //tsl.setGain(TSL2591_GAIN_HIGH);   // 428x gain
  
  // Changing the integration time gives you a longer time over which to sense light
  // longer timelines are slower, but are good in very low light situtations!
  //tsl.setTiming(TSL2591_INTEGRATIONTIME_100MS);  // shortest integration time (bright light)
  // tsl.setTiming(TSL2591_INTEGRATIONTIME_200MS);
  tsl.setTiming(TSL2591_INTEGRATIONTIME_300MS);
  // tsl.setTiming(TSL2591_INTEGRATIONTIME_400MS);
  // tsl.setTiming(TSL2591_INTEGRATIONTIME_500MS);
  // tsl.setTiming(TSL2591_INTEGRATIONTIME_600MS);  // longest integration time (dim light)

  /* Display the gain and integration time for reference sake */  
  Serial.println(F("------------------------------------"));
  Serial.print  (F("Gain:         "));
  tsl2591Gain_t gain = tsl.getGain();
  switch(gain)
  {
    case TSL2591_GAIN_LOW:
      Serial.println(F("1x (Low)"));
      break;
    case TSL2591_GAIN_MED:
      Serial.println(F("25x (Medium)"));
      break;
    case TSL2591_GAIN_HIGH:
      Serial.println(F("428x (High)"));
      break;
    case TSL2591_GAIN_MAX:
      Serial.println(F("9876x (Max)"));
      break;
  }
  Serial.print  (F("Timing:       "));
  Serial.print((tsl.getTiming() + 1) * 100, DEC); 
  Serial.println(F(" ms"));
  Serial.println(F("------------------------------------"));
  Serial.println(F(""));
}

uint16_t simpleRead(void)
{
  // Simple data read example. Just read the infrared, fullspecrtrum diode 
  // or 'visible' (difference between the two) channels.
  // This can take 100-600 milliseconds! Uncomment whichever of the following you want to read
  return tsl.getLuminosity(TSL2591_VISIBLE);
  //uint16_t x = tsl.getLuminosity(TSL2591_FULLSPECTRUM);
  //uint16_t x = tsl.getLuminosity(TSL2591_INFRARED);
}

void setup() {
  // Debugging output
  Serial.begin(9600);

  if (tsl.begin()) 
  {
    Serial.println(F("Found a TSL2591 sensor"));
  } 
  else 
  {
    Serial.println(F("No sensor found ... check your wiring?"));
    while (1);
  }
  configureTSL();

  while (!Serial) {
    delay(1);
  }
  
  if (!as7341.begin()){
    Serial.println("Could not find AS7341");
    while (1) { delay(10); }
  }
  
  as7341.setATIME(100);
  as7341.setASTEP(999);
  as7341.setGain(AS7341_GAIN_256X);

  // set up the LCD's number of columns and rows: 
  lcd.begin(16, 2);

  // Print a message to the LCD. We track how long it takes since
  // this library has been optimized a bit and we're proud of it :)
  //lcd.print("Hello, world!");
  lcd.setBacklight(WHITE);
  screen_on = true;
}

void loop() {
  uint8_t buttons = lcd.readButtons();

  if (buttons) {
    if (buttons & BUTTON_SELECT) {
      lcd.clear();
      tsl_read = simpleRead();
      
      uint16_t as7341_readings[12];
      if (!as7341.readAllChannels(as7341_readings)){
        Serial.println("Error reading all channels!");
        return;
      }
      
      lcd.setCursor(0, 0);
      lcd.print(tsl_read);
      // set the cursor to column 0, line 1
      // (note: line 1 is the second row, since counting begins with 0):
      lcd.setCursor(0, 1);
      // print the number of seconds since reset:
      lcd.print(String(as7341_readings[0]) + " " + String(as7341_readings[3]) + " " + String(as7341_readings[11]));
    }
    if ((buttons & BUTTON_UP) || (buttons & BUTTON_DOWN) || (buttons & BUTTON_LEFT) || (buttons & BUTTON_RIGHT)) {
      if (screen_on == true) {
        lcd.setBacklight(TEAL);
        screen_on = false;
      }
      else {
        lcd.setBacklight(RED);
        screen_on = true;
      }
    }
  }  
   
  delay(100);
}
