chevalierid/alan-setup/(commit log)

2022-11-03 adding file to just test the light and write dummy sensor data
2022-11-03 switches light on and off every 5 seconds
2022-11-04 switches light on and off every hour while writing sensor data to file that changes name hourly (I think)
2022-11-04 fixed filename bug and switching bug; now switches every min for 10min
    [sd_test_light.ino]
2023-05-09 override button functionality, improved printing including white and amber (printing to file commented out but functional)
2023-07-01 scheduling file now goes from current day rather than tomorrow
    [schedule_data_v4.csv]
2024-02-01 reorganising and adding controller PCB files
    [controller_pcb.kicad_sch, schedule_data_v4.csv]
2024-02-06 updated 15v and 5v schematics to support parallel design (both receiving 6V-20V battery input) and constant current via 1A current limit on the 15v regulator
    [15VBOM.csv, 1ABOM.csv, 1ABOM2.csv, 5VBOM.csv, 5VBOM2.csv, WBBOMDesign2.csv, WBBOMDesign3.csv, WBBOMDesignTPS55289RYQR.csv]
2024-02-07 added RTC circuit just need to sub in battery clip when found. decided to keep current SD setup rather than integrating into PCB
2024-02-09 added MOSFET to 15V and finished connections (hopefully); next step annotation
2024-02-21 started layout; about to rename pins
    [controller_pcb.csv]
2024-02-22 draft board layout
2024-02-23 before renaming/merging ground nets
2024-03-28 final v1 PCB schematics
2024-03-28 import controller_pcb content
    [controller_pcb-B_Cu.gbl, controller_pcb-B_Mask.gbs, controller_pcb-B_Paste.gbp, controller_pcb-Edge_Cuts.gm1, controller_pcb-F_Cu.gtl, controller_pcb-F_Mask.gts, controller_pcb-F_Paste.gtp, controller_pcb-F_Silkscreen.gto]
2024-04-04 a bunch of preprocessing in new rmd file
    [Collection Date, Site Treatment, & Notes.xlsx, Collection_Date_Site_Treatment_Notes.csv, Long Collection Date, Site Treatment, & Notes.csv, Pitfall_Trap_Biomass_Data.csv, Pitfall_Trap_Biomass_Data.xlsx, site_states.csv]
2024-04-19 v2 of PCB
    [controller_pcb.kicad_pcb, controller_pcb.kicad_sch]
2024-04-29 old processing file and new refactored setup
    [0-0-0.CSV, 0-0-13.CSV, 0-0-28.CSV, 0-0-30.CSV, 0-0-39.CSV, 0-12-0.CSV, 0-12-30.CSV, 0-12-4.CSV]
2024-07-01 before it's changed to fully switch labelledsites to sites
    [Collection Date Site Treatment and Notes(LongFormat).csv, Collection Date Site Treatment and Notes(Manual).csv, Collection Date Site Treatment and Notes.csv, Collection Date Site Treatment and Notes_old.csv, metadata.csv, raw_sensor_metadata_collated.csv]
2024-07-03 scratch work in treatment-fixing area for manual changepoints preserved
    [Collection Date Site Treatment and Notes(LongFormat).csv, Collection Date Site Treatment and Notes(Manual).csv, raw_sensor_metadata_collated.csv]
