chevalierid/alan-setup/(notices)

Notices in the files:
fab/kicad/controller_pcb.kicad_sch:
creativecommons.org/licenses/by/4.0
License: CC BY 4.0
